huiyi-li/esp32_show_tv/cad/solidcraft/prismtv.png

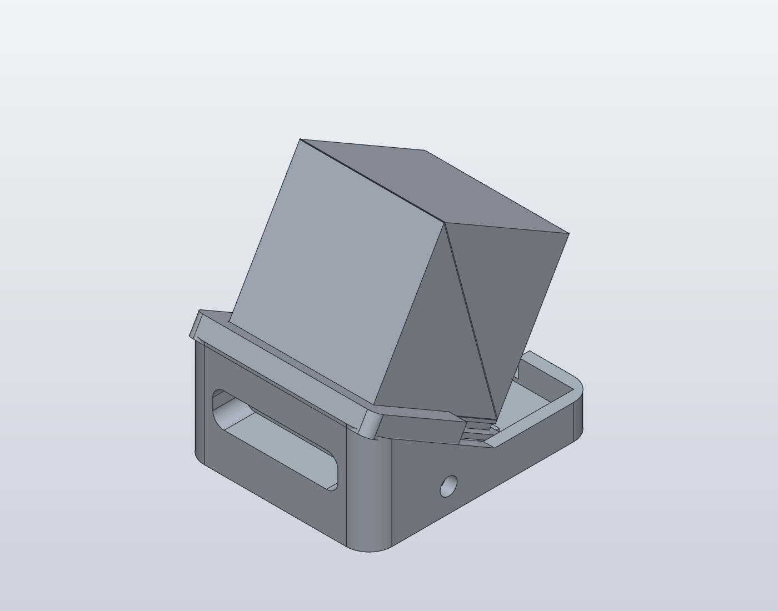
cad/solidcraft/prismtv.png
