huiyi-li/esp32_show_tv/DESIGN.md

# 25.4mm 分光棱镜「透明智能小电视」设计方案

> 参考项目：HoloCubic / 分光棱镜透明桌面小电视
> 核心器件：ESP32-PICO-D4 + MPU6050 + BH1750 + ST7789S(1.3" 240×240 IPS)
> 关键约束：25.4mm 分光棱镜立方体；两块 PCB（屏幕板 + 主板）

---

## 0. 参考项目原理（先对齐目标）

1:1 分光棱镜（Beam Splitter Cube）由两块直角棱镜胶合，胶合面镀 50/50 分光膜。

- 屏幕**水平放置、发光面朝上**，贴在中空的底座里。
- 25.4mm 立方体压在屏幕正上方，分光面与水平面成 **45°**。
- 屏幕向上的光，一半被 45° 分光面**反射到正面观察方向**，一半透射穿过后方。
- 观察者从前/侧方看，会看到**屏幕的镜像悬浮在立方体内部**，同时能透过立方体看到背景 → "透明"效果。

要复刻/超越它，光学几何是最硬约束，PCB 和结构都得围绕它让步。

---

## 1. 器件资料梳理

### 1.1 ESP32-PICO-D4（主控，SiP 系统级封装）

| 项目 | 参数 |
|---|---|
| 封装 | LGA-48，**7.0 × 7.0 × 0.94 mm** |
| 内核 | ESP32 双核 Xtensa LX6，最高 240 MHz |
| 片内 | **4 MB Quad-SPI Flash** + 40MHz 晶振 + RF 匹配 + 去耦，全部封装在内 |
| 无线 | 2.4GHz WiFi 802.11 b/g/n + BT 4.2 / BLE |
| 供电 | 2.7 – 3.6 V（标称 3.3 V） |
| 峰值电流 | WiFi TX 瞬时可达 ~500 mA（电源要留裕量） |

**必须注意的引脚：**

- `GPIO16 / GPIO17 / CMD / CLK / SD0 / SD1` 被内部 Flash 占用，**不可用**。
- **`GPIO6–11`** 同样接到内部 Flash（SPI0/1），**不可用**。
- 可用 GPIO：`0–5, 12–15, 18–23, 25–27, 32–39`。
- **Strapping 引脚（上电电平敏感）**：`0 / 2 / 5 / 12 / 15`
  - `GPIO12` 决定 Flash 电压，**上电时必须为低**，拉高会切到 1.8V 损伤内部 Flash → 干脆避开。
  - `GPIO5` 上电需为高（用作片选空闲态为高，OK）。
  - `GPIO15` 上电建议为高。
- `GPIO34/35/36/39` **仅输入**，无内部上拉。
- 无原生 USB → 必须外挂 USB-UART 桥。

> ⚠️ **选型提醒**：ESP32-PICO-D4 官方已标记 **NRND（不推荐新设计）**。量产/新项目建议换 **ESP32-PICO-V3-02**（8MB Flash + 2MB PSRAM，引脚基本兼容，PSRAM 对 LVGL 动画非常关键）。方案一/二可用 D4 打样验证，方案三直接上 V3-02。

### 1.2 MPU6050（六轴 IMU，姿态/手势）

| 项目 | 参数 |
|---|---|
| 封装 | QFN-24，**4 × 4 × 0.9 mm** |
| 测量 | 三轴加速度 ±2…±16g；三轴陀螺 ±250…±2000°/s |
| 接口 | I²C（0x68 / 0x69）或 SPI |
| 地址 | AD0 低 = **0x68**，AD0 高 = 0x69 |
| 供电 | 2.375 – 3.46 V |
| 额外 | 可编程中断 INT；内部温度计；DMP |
| 外围 | VDD 0.1µF + VLOGIC 10nF/0.1µF，CPOUT/REGOUT 按手册电容 |

> ⚠️ 市场**假片极多**（WHO_AM_I 读不到 0x68），且同样 NRND。建议备选 **QMI8658C**（3×3mm，0x6A/0x6B，国产好买）或 **ICM-42688-P**（低噪、SPI 快）。软件层做抽象，换片只改驱动。

### 1.3 BH1750FVI（数字环境光传感器）

| 项目 | 参数 |
|---|---|
| 封装 | WSOF6I 6 脚超小封装 |
| 量程 | **1 – 65535 lx**，16-bit 输出 |
| 接口 | I²C，最高 400kHz |
| 地址 | ADDR 低 = **0x23**，ADDR 高 = 0x5C |
| 供电 | 2.4 – 3.6 V |
| 引脚 | VCC / ADDR / GND / SDA / SCL / DVI（异步复位，按手册接电容或 VCC） |
| 外围 | VCC 1µF + 0.1µF |

**用途**：自动亮度（联动背光 PWM）；暗环境自动熄屏省电。
**地址不冲突**：BH1750 0x23 与 MPU6050 0x68 可共用一条 I²C 总线。

### 1.4 ST7789S（TFT 驱动，1.3" 240×240 IPS）

| 项目 | 参数 |
|---|---|
| 类型 | Sitronix 单芯片 TFT 驱动（ST7789 系列，注意核对"V/S"尾缀与面板规格） |
| 分辨率 | 240(RGB) × 320 源/栅，1.3" 面板实际用 **240×240** |
| 接口 | 4-line SPI（或 8080 并口） |
| 逻辑电压 IOVCC | **1.65 – 3.3 V**（3.3V 直连 ESP32 无需电平转换） |
| 模拟电压 VCC | 2.4 – 3.6 V |
| 颜色 | 262K / 65K |
| 升压 | VGH/VGL 内部电荷泵，**外接电容**（通常已做在面板 FPC 上） |
| 背光 | 白光 LED，Vf ≈ 2.8–3.2 V，约 15–20 mA |

**1.3" 240×240 模组常见 FPC（8-pin，0.5mm）**：`GND / VCC / SCL / SDA / RES / DC / CS / BLK`
→ 屏幕板只需：FPC 座 + 背光限流 + 少量去耦（驱动 IC 的电荷泵电容在面板上）。

### 1.5 25.4mm 分光棱镜（结构核心）

| 项目 | 参数 |
|---|---|
| 尺寸 | **25.4 × 25.4 × 25.4 mm**（±0.1mm），面对方正、棱边倒角 |
| 分光比 | 50 % R / 50 % T（宽带 400–700nm） |
| 胶合面 | 介质分光膜，装好后与水平面 45° |
| 可选 | 外表面 AR 镀膜（减少鬼影，强烈建议） |

**结论：屏幕有效区必须 ≤ 25.4mm。1.3" 240×240 的有效显示区约 23.4 × 23.4 mm，正好塞进 25.4mm 立方体并留约 1.0mm 遮光边 —— 这是选它的根本原因。**

### 1.6 I²C 总线上游/下游地址分配（不冲突）

| 器件 | 7-bit 地址 | 总线 |
|---|---|---|
| MPU6050 | 0x68 | 主板 I²C |
| BH1750 | 0x23 | 主板 I²C（或经板对板走 SDA/SCL） |

---

## 2. 光学与结构约束（一切设计的前提）

1. **屏幕居中**：显示区中心必须与棱镜底面中心重合并平行，偏差 < 0.5mm，否则出现色偏/重影。
2. **贴合间隙**：面板发光面尽量靠近棱镜底面（间隙 0.3–1mm），间隙越大鬼影越明显。
3. **遮光**：屏幕与棱镜之间加**黑色遮光框/遮光棉**，只在显示区留窗；否则漏光会在棱镜里形成"底光"。
4. **装棱镜方向**：分光面法线需在水平面内，使"底面朝上的光 → 反射到正面观察方向"。装反了就是从背面看。
5. **固定方式**：结构卡座 + 硅胶垫限位，**禁止用会发雾/析出的胶**粘镜面；可在棱镜**棱边**点 UV 胶固定。
6. **视角**：±30° 内成像稳定；大角度会看到立方体棱边的二次反射，属正常。
7. **背光散热**：背光 LED 发热，屏幕板在 LED 区铺铜并接到主板地。
8. **可选进阶**：棱镜底面与面板之间做**光学胶/折射率匹配**或给棱镜外表面加 AR 膜，可显著降低双影。

---

## 3. 为什么拆两块 PCB（屏幕板 + 主板）

棱镜正下方只有 25.4mm 窗口，越薄越干净；而 MCU/电源/USB/传感器堆叠密度大、需要更大面积。因此天然分成两块：

| | 屏幕板（Display Board） | 主板（Main Board） |
|---|---|---|
| 位置 | 棱镜正下方，紧贴面板 | 屏幕板下方，底座内 |
| 尺寸建议 | **≤ 28 × 28 mm** | 30 × 35 mm 左右，可调味 |
| 层数 | 2 层 | 4 层（WiFi 强烈建议） |
| 内容 | 面板 FPC 座、背光驱动（限流/恒流+PWM MOSFET）、ESD、去耦、（可选）BH1750 朝外 | ESP32-PICO-D4、USB-C+ESD、USB-UART 桥、3.3V 电源、自动下载电路、按键、MPU6050、触摸焊盘、测试点 |
| 传感器放哪 | **BH1750 放屏幕板顶端朝外**（采真实环境光，不被棱镜/外壳挡） | **MPU6050 放主板**（减薄屏幕板，且整机倾角一致） |

### 3.1 两板互联接口定义（推荐 12-pin）

| Pin | 信号 | 说明 |
|---|---|---|
| 1 | 3V3 | 显示屏 IOVCC/VCC |
| 2 | GND | 地 |
| 3 | GND | 地（双地降低 SPI 回流噪声） |
| 4 | TFT_SCLK | SPI 时钟 |
| 5 | TFT_MOSI | SPI 数据 |
| 6 | TFT_CS | 片选 |
| 7 | TFT_DC | 数据/命令 |
| 8 | TFT_RST | 复位（可共享 EN） |
| 9 | TFT_BL | 背光 PWM |
| 10 | I2C_SDA | 给屏幕板 BH1750（若 BH1750 放主板则删掉） |
| 11 | I2C_SCL | 同上 |
| 12 | GND | 屏蔽/机械地 |

**连接器选型**：0.4/0.5mm pitch 板对板（Hirose DF40、Molex SlimStack，高度 1.5–3.0mm），或 0.5mm 12P FPC 带补强板 Z 型折弯。两板间隙建议 2–4mm，且主板元件尽量放**背面朝下**，避免顶到屏幕板。

---

## 4. 通用 PCB 设计要点（三方案共用）

### 4.1 叠层与阻抗
- **主板 4 层**：`Top(Sig) / GND(完整) / PWR / Bottom(Sig)`。ESP32 要有一个**不打洞的完整参考地**。
- **屏幕板 2 层**：正面信号，背面整片 GND，SPI 走线两侧包地。
- 若用外置天线：馈线 **50Ω 共面波导**，长度尽量短。

### 4.2 天线
- 板载 PCB 天线（倒 F / 蛇形）净空区约 **15 × 8 mm**：该区**不许铺铜、不许走线、不许上螺钉/金属**。
- 净空区放在**主板远离棱镜、远离电池**的边缘；整机装配后棱镜/屏幕在另一侧，不挡天线。
- 空间紧张直接用 **U.FL + 外置 FPC 天线**，贴在外壳非金属区。

### 4.3 电源
- 5V→3.3V：优先 **同步 Buck**（如 TPS62162/MP2315），效率高、压差小；空间允许可用低噪 LDO（RT9013/AP2112）做"干净 3.3V"给屏和传感器。
- ESP32 电源脚：每脚 **0.1µF + 就近 10~22µF 大容量**，应对 WiFi TX 电流尖峰。
- 背光：**PWM MOSFET（2N7002）+ 限流电阻**，PWM 频率 **> 10kHz** 避免可见频闪；白光 LED 可加恒流驱动（如 SGM3140）保证亮度一致。
- USB-C 入口：**USBLC6-2SC6** 之类 ESD；CC1/CC2 各 5.1k 下拉（做 Sink）。

### 4.4 去耦清单
- ESP32-PICO-D4：模块自带滤波，外围补 10µF + 0.1µF。
- MPU6050：0.1µF + 手册推荐的 0.1µF/10nF（VLOGIC）+ CPOUT/REGOUT 电容。
- BH1750：1µF + 0.1µF。
- ST7789 电荷泵电容一般在**面板 FPC 上**，屏幕板只需 VCC 侧 1µF + 0.1µF。

### 4.5 信号完整性
- SPI 跨板对板连接器，走线尽量 < 5cm；如振铃，在 SCLK/MOSI 串 **22–33Ω** 源端电阻；速率先 40MHz，稳了再提。
- I²C：**4.7k 上拉**到 3.3V，走线短，与 SPI 保持间距避免串扰。
- USB D+/D-：**90Ω 差分对**，等长，包地。
- 所有跨板信号地回流要有相邻 GND pin。

### 4.6 可制造性/可调试性
- 预留测试点：`3V3 / GND / TX / RX / EN / IO0 / SDA / SCL / SCLK / MOSI`。
- 屏幕板与主板都放 **Mark 点**（贴片机用）和 **安装孔**。
- 丝印标注 Pin1、连接器方向、棱镜"前/上"方向，避免装反。

---

## 5. 三个完整设计方案

---

### 方案一 ｜ 快速原型版（先点亮、验证光学）

**定位**：两周内出效果，验证驱动 + 光学 + 软件链路，牺牲体积与集成度。

**结构**
- 屏幕板 30×30mm，主板沿用现成 ESP32 开发板外形（约 40×60mm）。
- 两板用 **2.54mm 排针 + 杜邦线/FFC** 连接。
- 棱镜用 3D 打印 PLA 卡座架在屏幕上，缝隙塞黑色遮光泡棉。
- 无电池，USB 直供电；外壳省略或简单亚克力。

**硬件**
- 主板直接用**现成 ESP32-PICO-D4 核心板**（其自带 USB-UART + LDO），只画一块底板引出排针即可，甚至不画。
- 屏幕板：1.3" 240×240 FPC 座 + 背光电阻/MOSFET + 2×7 排针。
- 传感器用现成 GY-521(MPU6050)、GY-302(BH1750) 小板飞线接 I²C。

**软件**
- Arduino IDE + **TFT_eSPI**（`User_Setup.h` 配 240×240 ST7789，改 `ST7789_DRIVER`、`TFT_WIDTH 240 / TFT_HEIGHT 240`）。
- 单 `loop()`：NTP 对时（`NTPClient`，注意 +8h 时区）+ 心知天气 HTTP/`HTTPClient` 解析 JSON + `pushImage()` 播放取模图片数组。
- WiFi 直连（SSID/密码硬编码）。

**优点**：最快见效、成本最低。<br>
**缺点**：体积大、连线多、无电源管理、动画受 4MB Flash 限制。

---

### 方案二 ｜ 高集成双板版（★ 推荐主力方案）

**定位**：自用/小批量，体积收敛、功能完整、可量产。

**结构**
- 整机约 **36 × 36 × 45 mm**：3D 打印/CNC 外壳，内部黑色内衬遮光。
- **屏幕板 28×28mm** 紧贴棱镜底面，遮光框留显示窗。
- **主板 30×32mm**，垂直置于屏幕板下方约 3mm，用 **0.5mm 12P 板对板连接器**连接。
- 棱镜卡座限位 + 顶部磁吸前盖，方便取放棱镜。
- 侧面开 BH1750 透光窗（不被棱镜/手挡）、USB-C 开口；外壳内侧贴铜箔做电容触摸条。

**硬件**
- **主板（4 层）**：ESP32-PICO-D4 + USB-C(TVS) + CH340C/CV3000P + 自动下载电路(2× SOT-23 三极管 DTR/RTS→EN/IO0) + BOOT/EN 按键 + 3.3V Buck/LDO + MPU6050 + BH1750 + 触摸焊盘 + 可选 WS2812 + 测试点。
- **屏幕板（2 层）**：0.5mm FPC 座 + 背光限流 + PWM MOSFET + ESD + 去耦 + 板对板连接器。
- 天线：主板边缘 PCB 天线，净空区远离棱镜与屏幕。

**软件（ESP-IDF 或 Arduino-as-component）**
- **LVGL 8/9** 做 UI，SPI 40MHz；双缓冲需约 2×(240×240×2/10) ≈ 23KB，D4 的 4MB Flash 够用，帧缓存放内部 RAM 分块刷。
- **FreeRTOS 多任务**：

  | 任务 | 核心 | 职责 |
  |---|---|---|
  | `ui_task` | Core1 | LVGL 刷新、动画、页面切换 |
  | `sensor_task` | Core0 | 10–50Hz 读 MPU6050 + BH1750，做自动亮度/翻转/摇动 |
  | `net_task` | Core0 | WiFi、NTP、天气 HTTP、图片 WebSocket 接收 |
  | `pwr_task` | Core0 | 空闲降频/熄屏、背光 PWM 联动 |

- **配网**：AP 模式 + 内置网页（WiFiManager 或自建），mDNS `holocubic.local`。
- **图片/动图**：PC/手机网页把 GIF/JPEG 通过 **WebSocket/HTTP 上传**到 ESP32 解码显示（比取模数组灵活）。
- **OTA**：`ArduinoOTA` 或 `esp_https_ota`。
- **交互**：MPU6050 翻转→切界面、摇一摇→换页；BH1750→自动亮度/熄屏；触摸条→上下页。

**优点**：体积小、体验完整、可复制。<br>
**缺点**：需画两块板 + 调结构。

---

### 方案三 ｜ 旗舰全功能版（可量产产品化）

**定位**：接近商品级，音视频、电池、一体化光学。

**结构**
- 一体化注塑/CNC 外壳 + **光学级装配**：棱镜底面与面板做折射率匹配/AR 膜，最大化消除双影。
- 前盖磁吸/卡扣，**兼容 15/20/25.4mm 棱镜**（换件即换尺寸）。
- 屏幕板集成**电容触摸条 + 朝外 BH1750 + 氛围灯**；主板堆电池、功放、SD 卡。
- 底部配重 + 硅胶防滑，重心低防倒。

**硬件**
- **主板（4–6 层）**：**ESP32-PICO-V3-02（8MB Flash + 2MB PSRAM，LVGL 双缓冲/视频帧）** + USB-C + 锂电充电（BQ24075/TP4056）+ 电量计（MAX17048）+ I²S 功放（NS4168）+ microSD + MPU6050(或 ICM-42688/QMI8658) + BH1750 + 触摸。
- **屏幕板**：高密板对板/屏蔽 FPC，含背光恒流、缓冲/串阻、温度检测。
- 双板用**屏蔽连接器**，SPI 提频到 60–80MHz。

**软件**
- **LVGL 9 + 多界面**：时钟/天气/相册/视频/设置。
- 视频/GIF **流式播放**（PSRAM 帧缓存 + 局部刷屏），WiFi 或 SD 卡读取。
- **BLE 配网 + Web/App 上传**、mDNS、OTA。
- **电源管理**：MPU6050 中断/触摸唤醒深睡眠；电量显示；低电保护。
- 传感器融合：姿态稳定显示方向，手势/轻敲交互。

**优点**：体验与形态最好、可产品化。<br>
**缺点**：BOM 成本、结构/光学调优、开发周期最长。

---

## 6. 三方案对比

| 维度 | 方案一 原型 | 方案二 高集成（推荐） | 方案三 旗舰 |
|---|---|---|---|
| 体积 | 大（>60×60×80） | ~36×36×45mm | ~34×34×42mm |
| PCB | 1–2 块，排针 | 双板，板对板 | 双板，屏蔽高密 |
| 层数 | 2 | 主板 4 / 屏板 2 | 主板 4–6 / 屏板 2 |
| 主控 | PICO-D4 核心板 | PICO-D4 | **PICO-V3-02(PSRAM)** |
| 显示 | TFT_eSPI | LVGL | LVGL9 + 视频 |
| 电源 | USB 直供 | USB-C + 3.3V | 锂电+充电+电量计 |
| 交互 | 无/串口 | 翻转/摇动/触摸/自动亮度 | 全手势+音频 |
| 联网 | 硬编码 WiFi | AP 配网 + OTA + 推图 | BLE 配网 + App + OTA |
| 周期 | ~2 周 | ~6–8 周 | ~3–4 月 |
| 适合 | 验证/教学 | 自用/小批量 | 产品化 |

---

## 7. 默认引脚分配（方案二/三可直接用）

| 功能 | ESP32-PICO 引脚 | 备注 |
|---|---|---|
| TFT_SCLK | GPIO18 | VSPI CLK |
| TFT_MOSI | GPIO23 | VSPI MOSI |
| TFT_CS | GPIO5 | 空闲为高，满足 strapping |
| TFT_DC | GPIO27 | |
| TFT_RST | GPIO33 | 或接 EN |
| TFT_BL | GPIO32 | LEDC PWM，>10kHz |
| I²C SDA | GPIO21 | 4.7k 上拉 |
| I²C SCL | GPIO22 | 4.7k 上拉 |
| MPU6050 INT | GPIO34 | 仅输入，OK |
| 触摸条 | GPIO4 | ESP32 Touch T0 |
| 状态灯/WS2812 | GPIO25 | |
| VBUS 检测 | GPIO35 | 仅输入 |
| BOOT | GPIO0 | 按键/strapping |
| EN | EN | 按键 + RC 复位 |

**禁用**：`GPIO6–11、16、17`（内部 Flash）；`GPIO12`（Flash 电压，勿拉高）。

---

## 8. 风险与选型建议清单

1. **ESP32-PICO-D4 = NRND** → 新项目优先 **PICO-V3-02**（+PSRAM，动画/视频必需）。
2. **MPU6050 假片多且 NRND** → 优先 **QMI8658C / ICM-42688-P**，驱动做抽象。
3. **棱镜鬼影/双影** → 面板贴近棱镜 + 遮光框 + 棱镜 AR 膜/折射率匹配。
4. **背光频闪** → PWM >10kHz；多颗 LED 用恒流驱动保亮度一致。
5. **WiFi 电流尖峰导致复位** → 模块旁 22µF + 0.1µF，走线短粗。
6. **天线被挡** → 净空 15×8mm，远离棱镜/电池/整片地；必要时外置 FPC 天线。
7. **4MB Flash 装不下动画** → 用 WiFi 推流/SD 卡，或直接上 PSRAM 版。
8. **SPI 跨板振铃** → 源端串 22–33Ω，先 40MHz 再提。
9. **棱镜固定发雾** → 只在棱边点 UV 胶 + 硅胶垫，禁止胶接触镜面。
10. **电池安全** → 走正规充电 IC，加过放/过流保护。

---

## 9. 下一步建议

1. 先按**方案一**用现成模块点亮 ST7789 + NTP/天气，确认光学效果。
2. 同步定 **1.3" 240×240 ST7789S 面板 FPC 定义**（脚位/背光电压）和**棱镜规格**（25.4mm/50:50/是否 AR）。
3. 冻结**方案二**的 12P 板对板接口与两板尺寸，出 3D 结构验证棱镜装配。
4. 最后决定是否上 PSRAM 版做**方案三**。
