huiyi-li/esp32_show_tv/cad/out/render/01_整机_等距.png

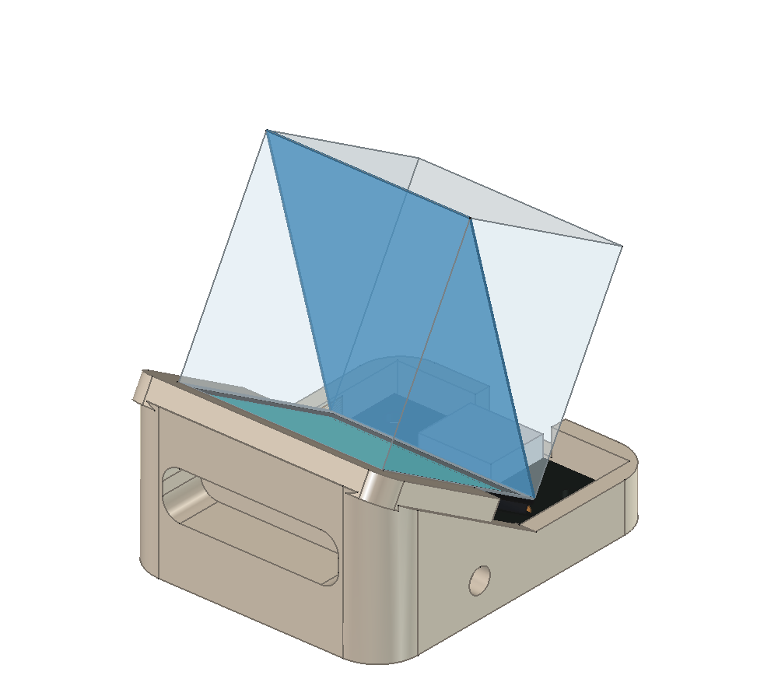
cad/out/render/01_整机_等距.png
