huiyi-li/esp32_show_tv/cad/out/render/02_整机_用户视角.png

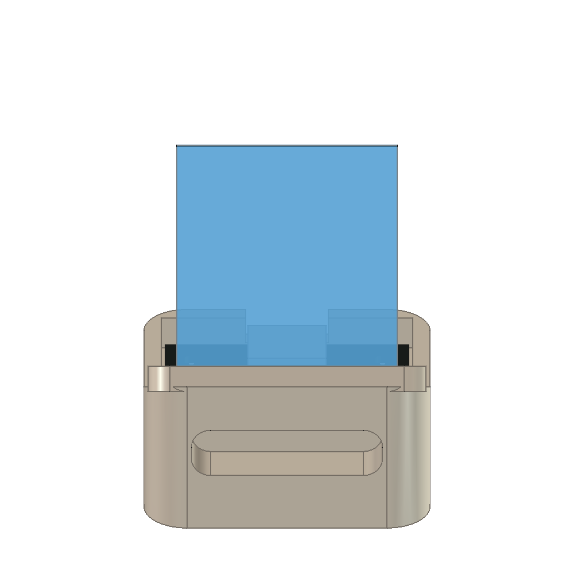
cad/out/render/02_整机_用户视角.png
