huiyi-li/esp32_show_tv/cad/out/render/03_整机_侧视.png

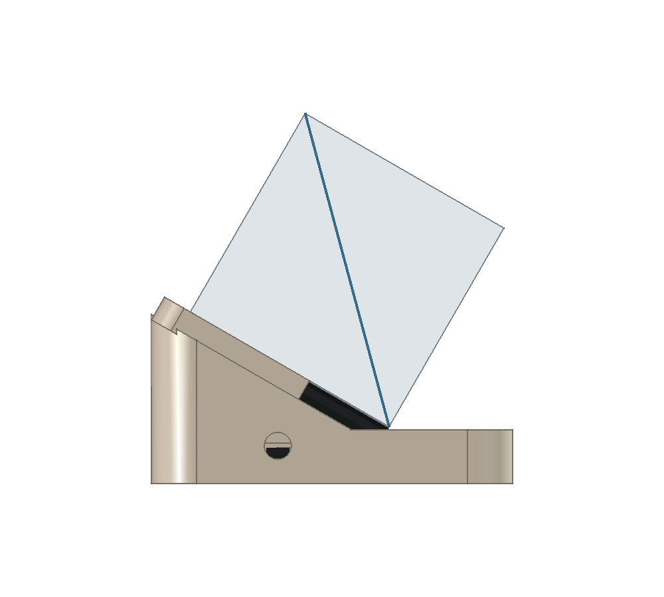
cad/out/render/03_整机_侧视.png
