huiyi-li/esp32_show_tv/cad/out/render/05_去掉棱镜_看显示.png

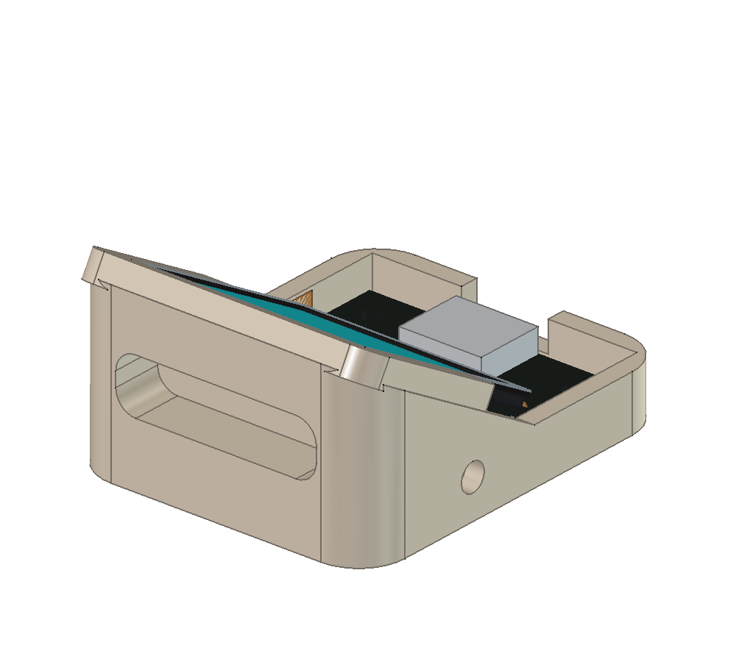
cad/out/render/05_去掉棱镜_看显示.png
