huiyi-li/esp32_show_tv/cad/out/render/06_主板元件面.png

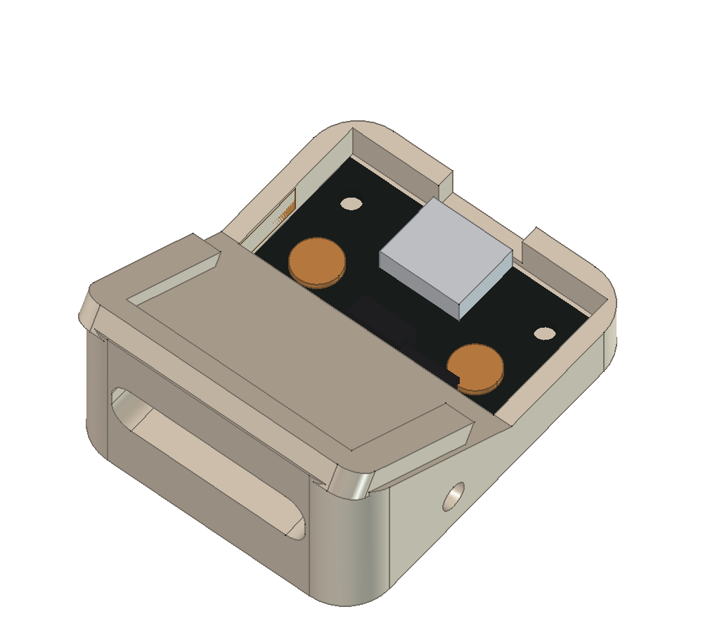
cad/out/render/06_主板元件面.png
