huiyi-li/esp32_show_tv/cad/out/render/07_爆炸图.png

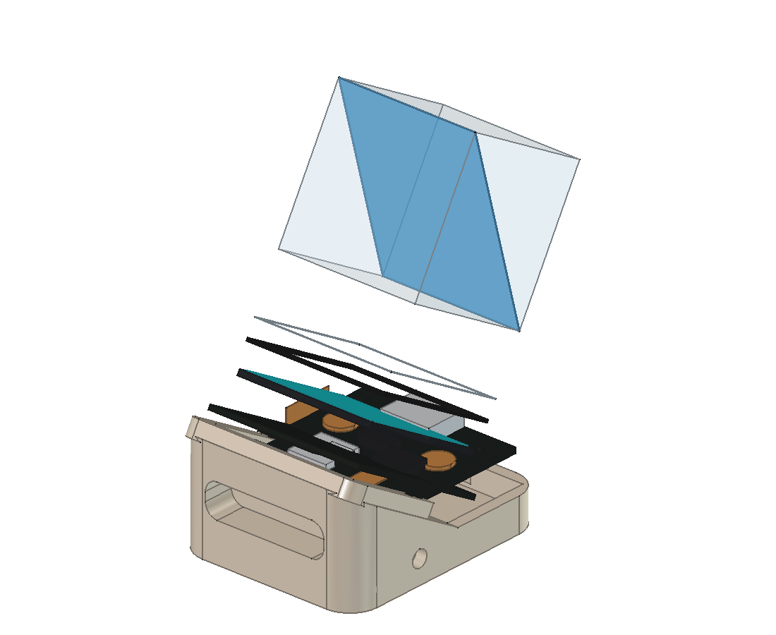
cad/out/render/07_爆炸图.png
