huiyi-li/esp32_show_tv/cad/out/render/08_剖视_光路.png

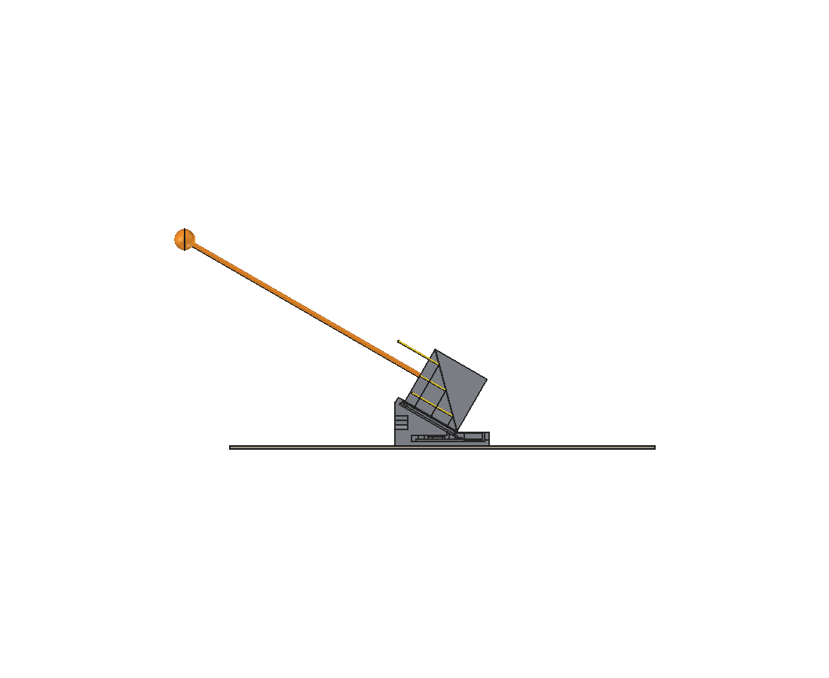
cad/out/render/08_剖视_光路.png
