huiyi-li/esp32_show_tv/cad/out/图纸/P01_外壳底座_零件图.png

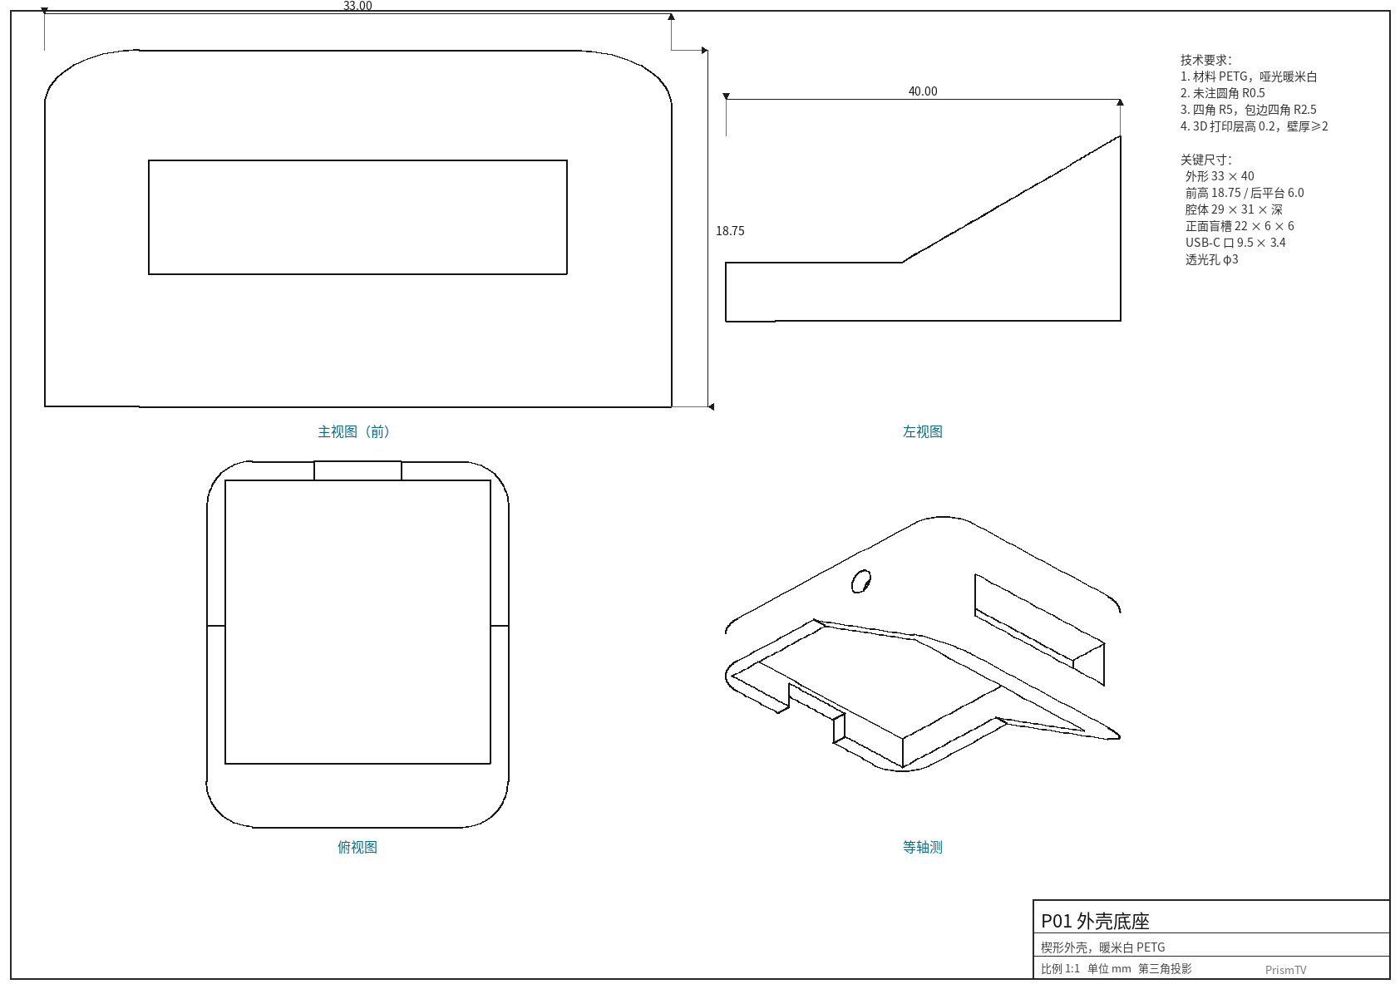
cad/out/图纸/P01_外壳底座_零件图.png
