huiyi-li/esp32_show_tv/cad/out/图纸/P02_棱镜托台_零件图.png

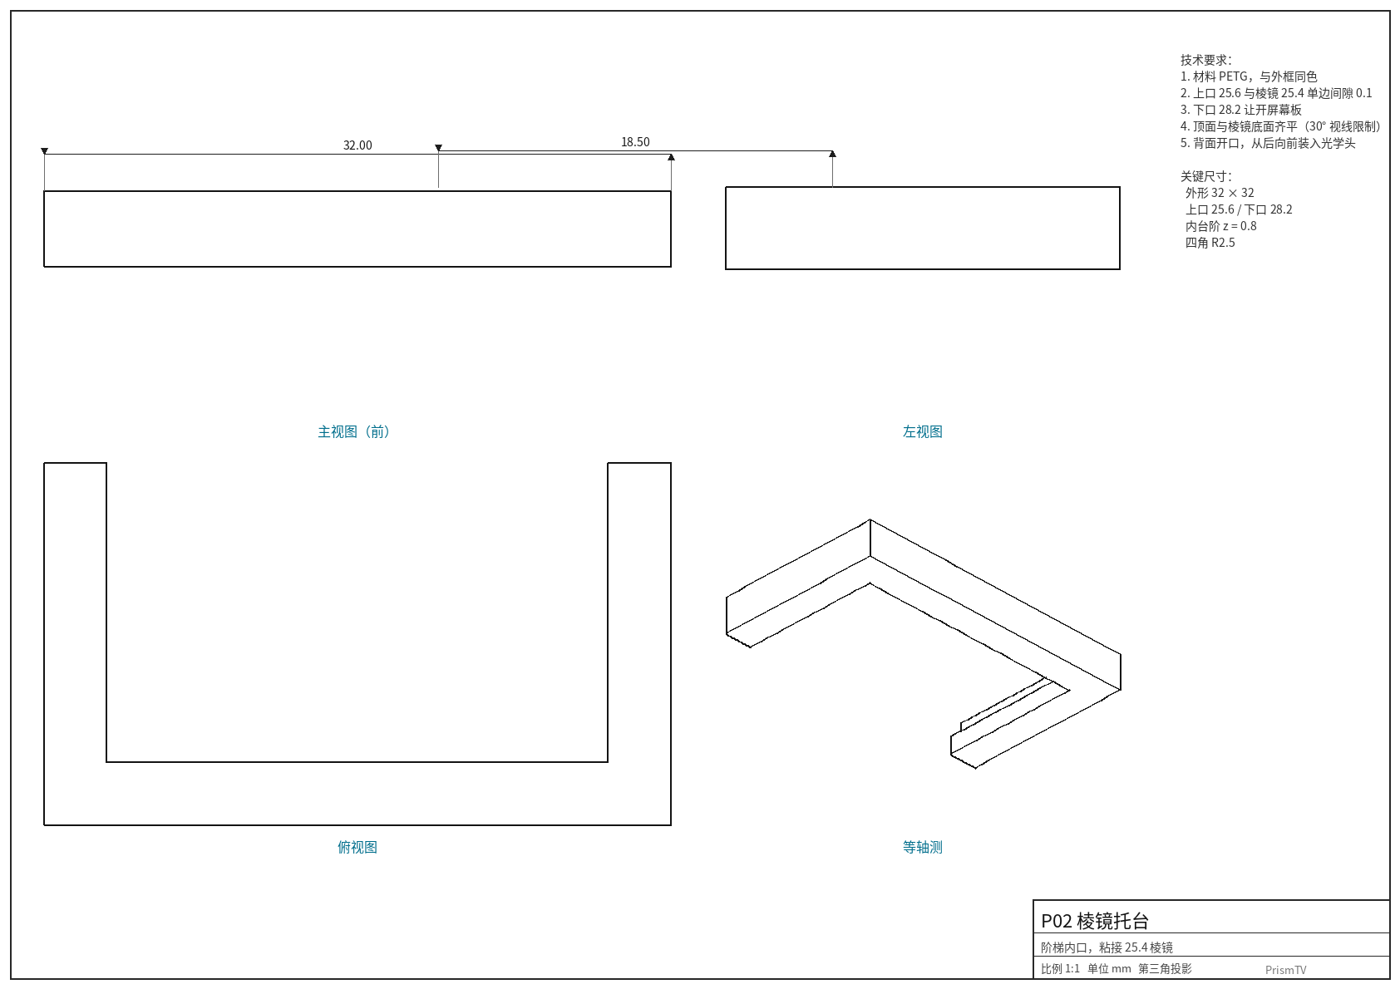
cad/out/图纸/P02_棱镜托台_零件图.png
