huiyi-li/esp32_show_tv/cad/out/渲染总览.png

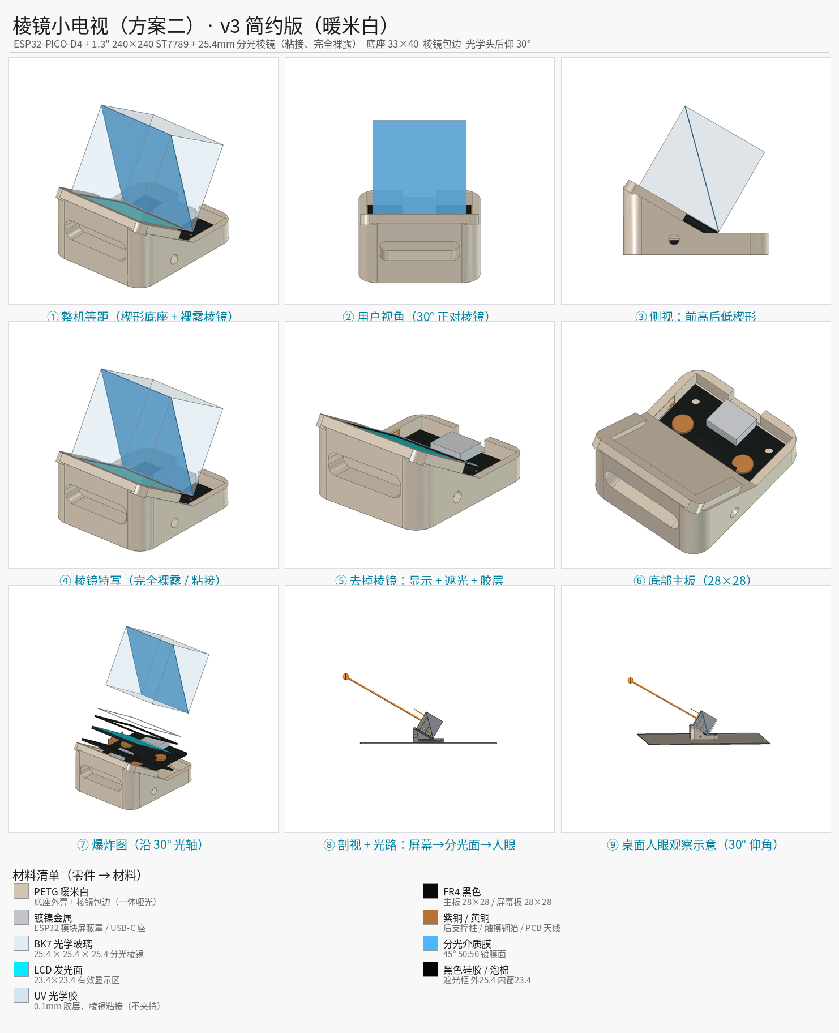
cad/out/渲染总览.png
