huiyi-li/esp32_show_tv/cad/out_v1_vertical/render/02_正视_观察方向.png

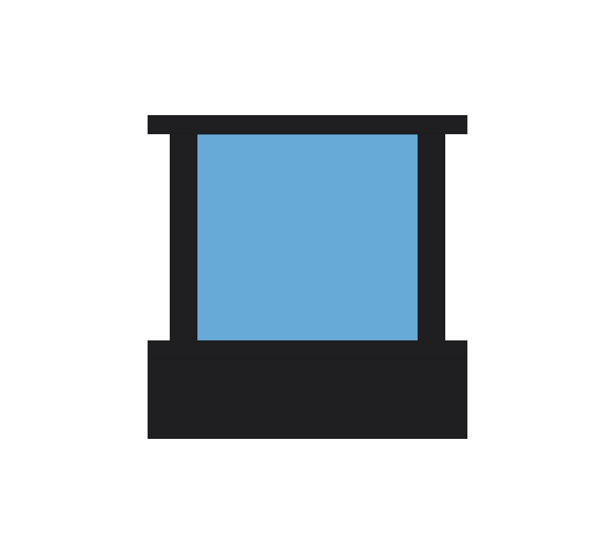
cad/out_v1_vertical/render/02_正视_观察方向.png
