huiyi-li/esp32_show_tv/cad/out_v1_vertical/render/03_侧视.png

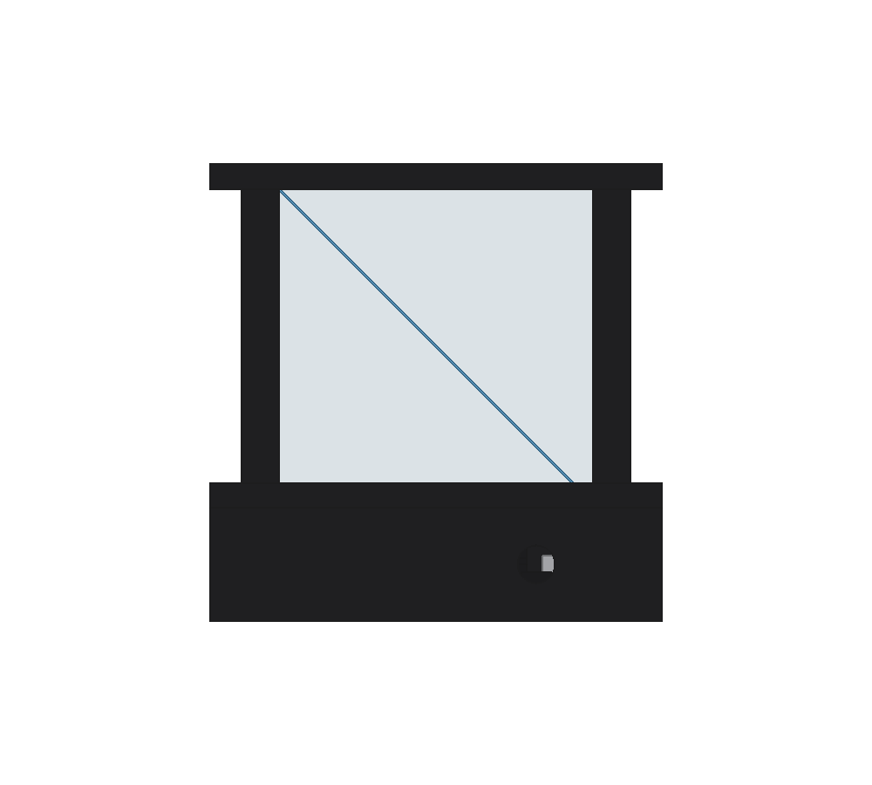
cad/out_v1_vertical/render/03_侧视.png
