huiyi-li/esp32_show_tv/cad/out_v1_vertical/render/05_内部双板结构.png

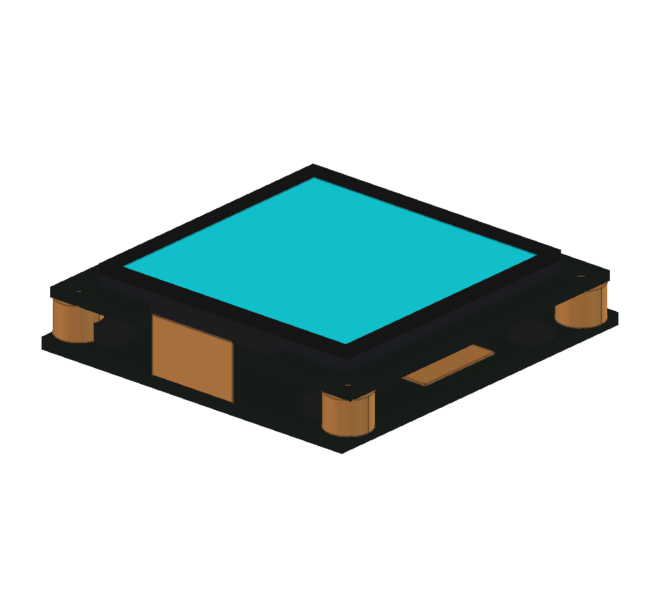
cad/out_v1_vertical/render/05_内部双板结构.png
