huiyi-li/esp32_show_tv/cad/out_v1_vertical/render/05b_主板元件面.png

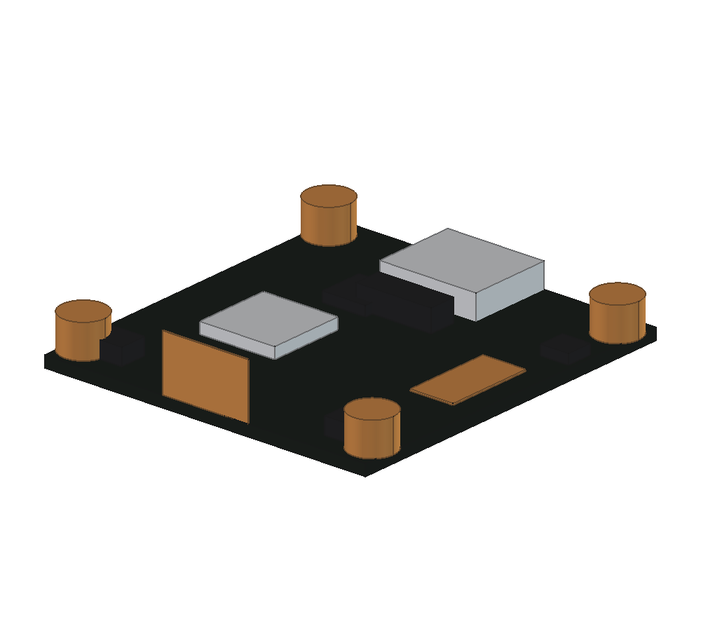
cad/out_v1_vertical/render/05b_主板元件面.png
