huiyi-li/esp32_show_tv/cad/out_v1_vertical/render/06_显示与遮光层.png

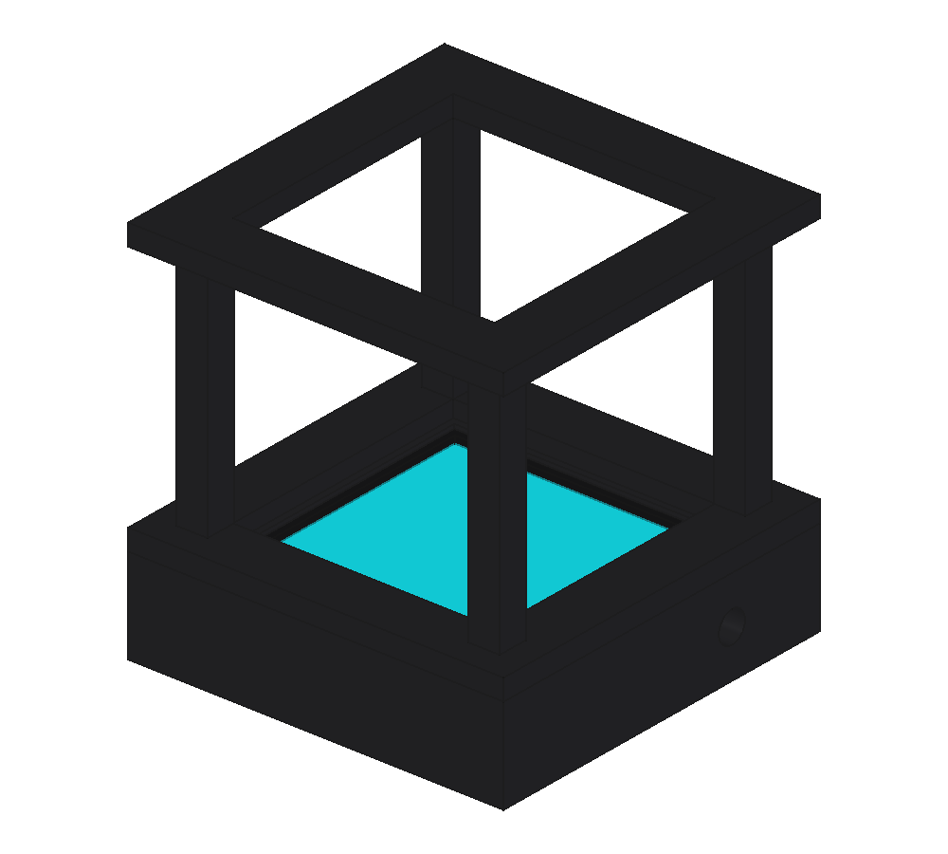
cad/out_v1_vertical/render/06_显示与遮光层.png
