huiyi-li/esp32_show_tv/cad/out_v1_vertical/render/07_爆炸图.png

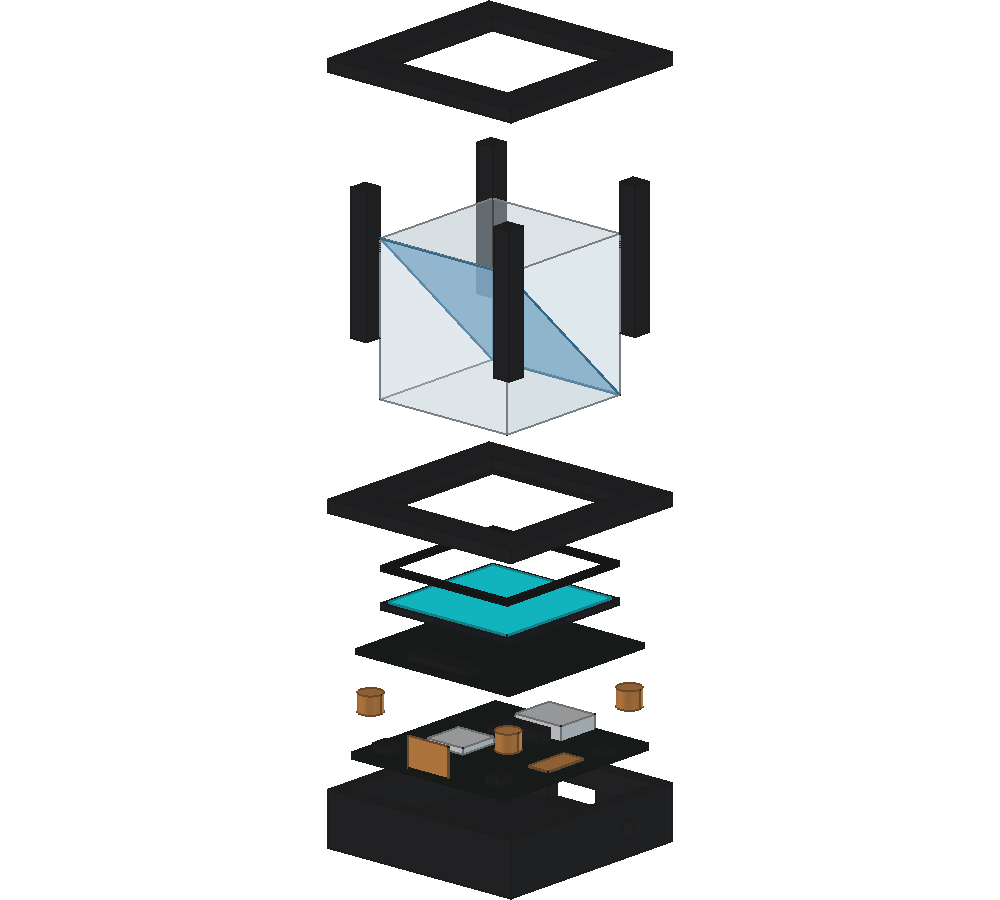
cad/out_v1_vertical/render/07_爆炸图.png
