huiyi-li/esp32_show_tv/cad/out_v1_vertical/render/08_剖视_光路.png

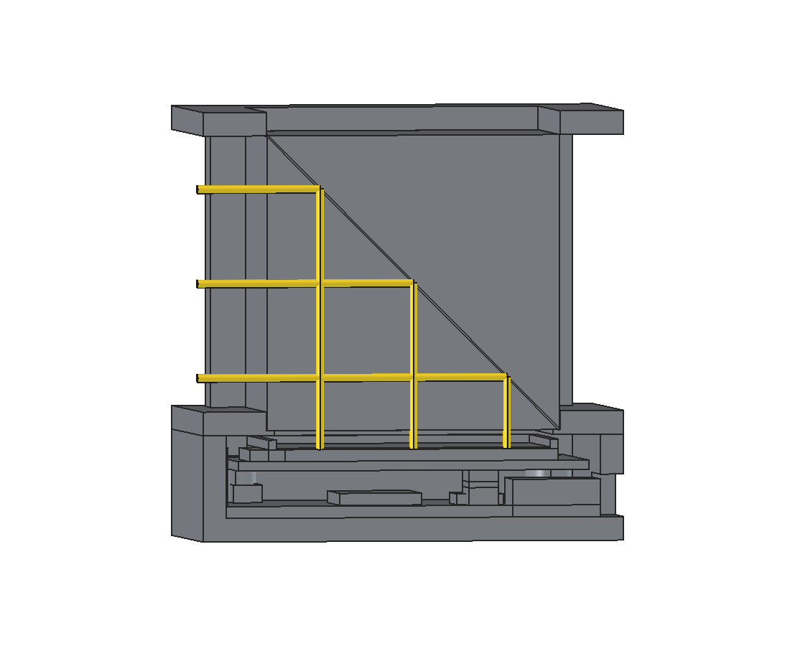
cad/out_v1_vertical/render/08_剖视_光路.png
