huiyi-li/esp32_show_tv/cad/out_v1_vertical/render/09_光路_总览.png

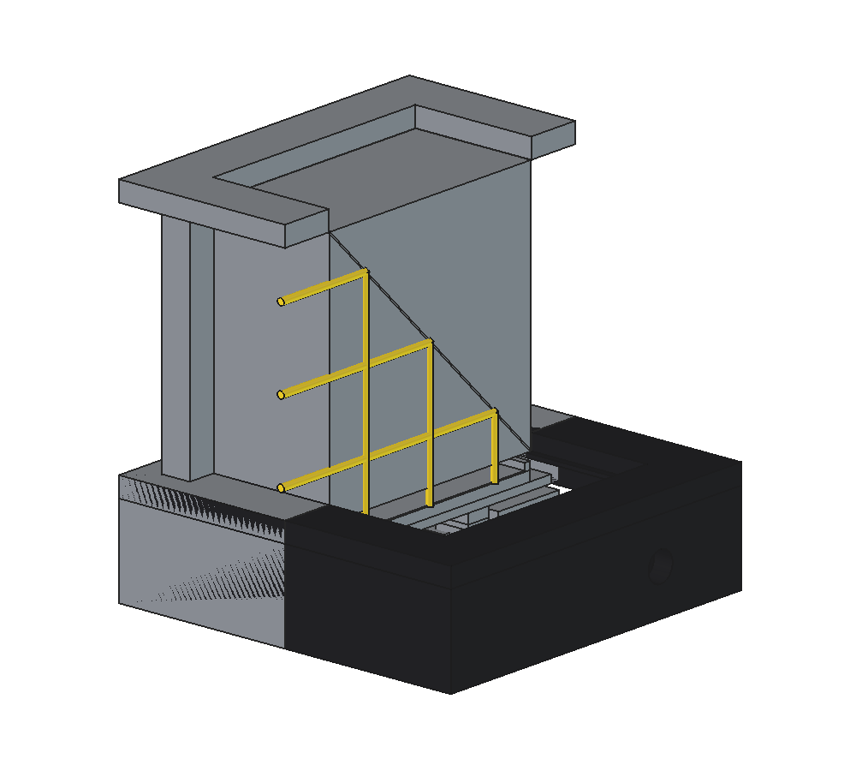
cad/out_v1_vertical/render/09_光路_总览.png
