huiyi-li/esp32_show_tv/cad/out_v1_vertical/渲染总览.png

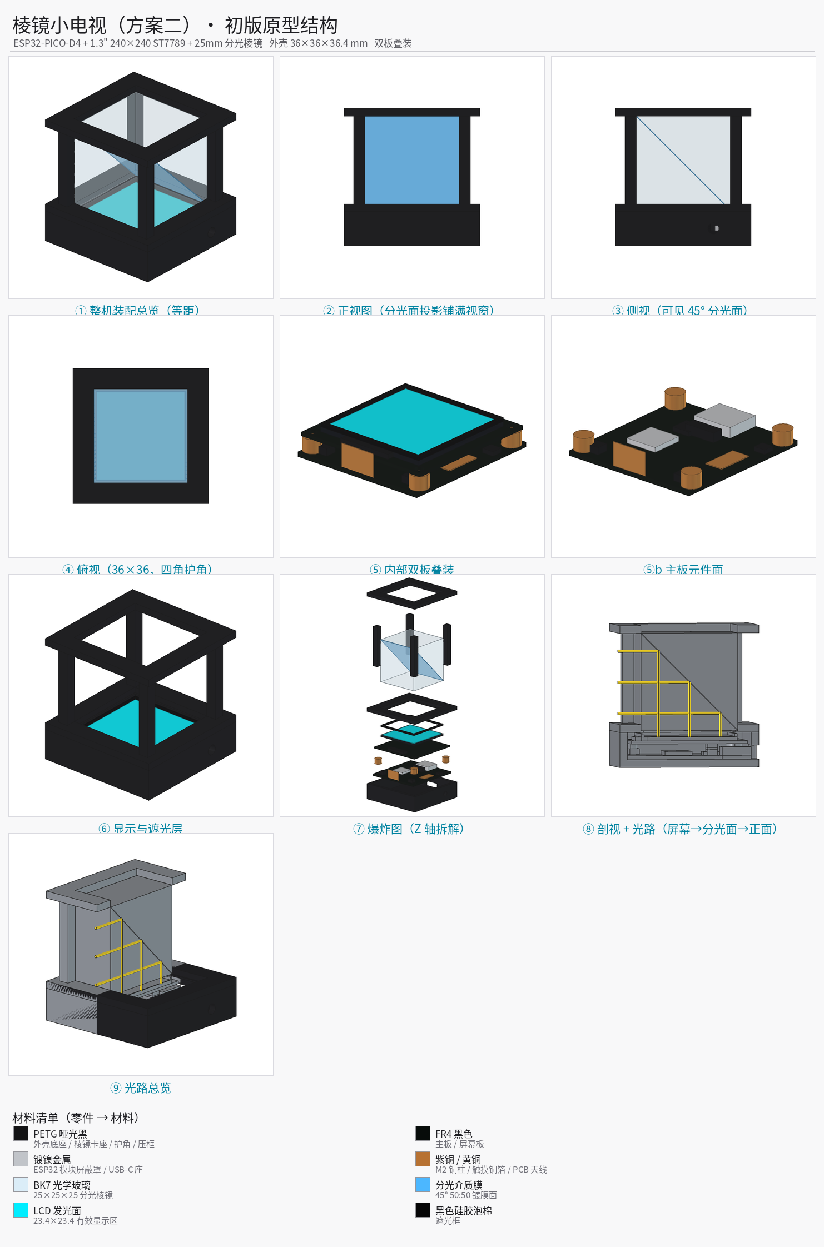
cad/out_v1_vertical/渲染总览.png
