huiyi-li/esp32_show_tv/cad/out_v2_tilt30/render/02_用户视角_正对棱镜.png

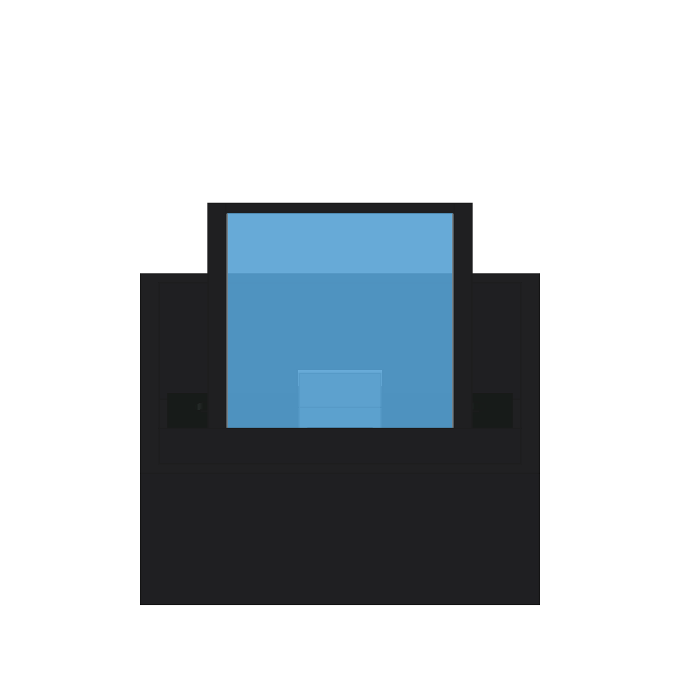
cad/out_v2_tilt30/render/02_用户视角_正对棱镜.png
