huiyi-li/esp32_show_tv/cad/out_v2_tilt30/render/03_侧视_30度仰角.png

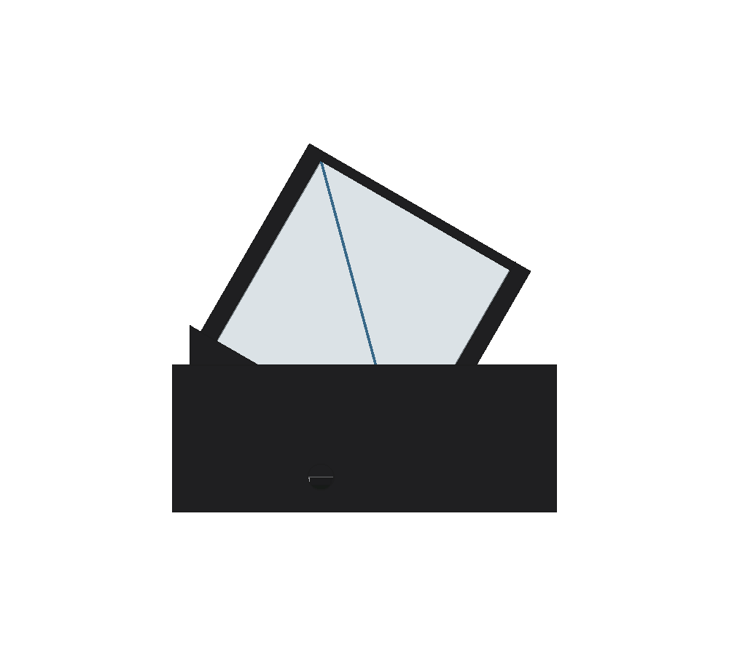
cad/out_v2_tilt30/render/03_侧视_30度仰角.png
