huiyi-li/esp32_show_tv/cad/out_v2_tilt30/render/04_俯视.png

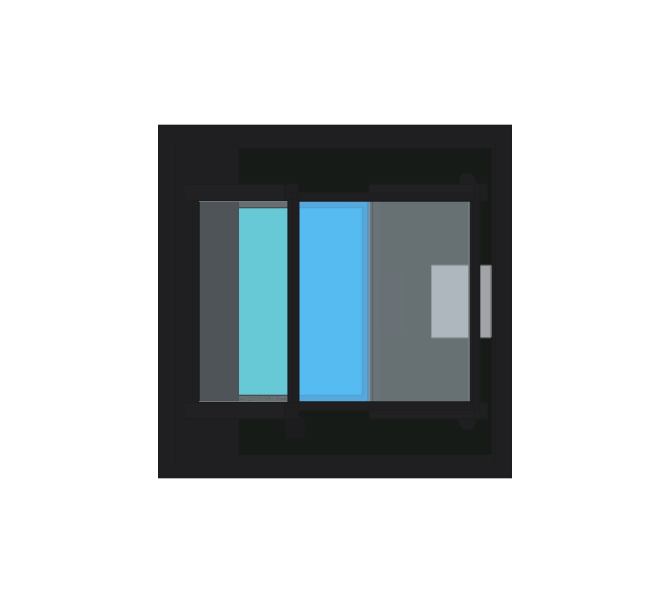
cad/out_v2_tilt30/render/04_俯视.png
