huiyi-li/esp32_show_tv/cad/out_v2_tilt30/render/05_光学头_内部.png

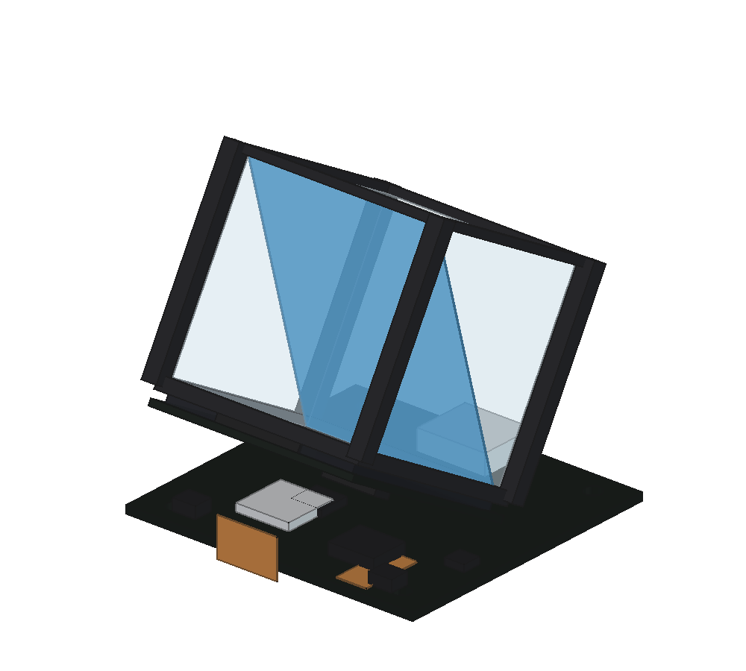
cad/out_v2_tilt30/render/05_光学头_内部.png
