huiyi-li/esp32_show_tv/cad/out_v2_tilt30/render/06_显示与遮光层.png

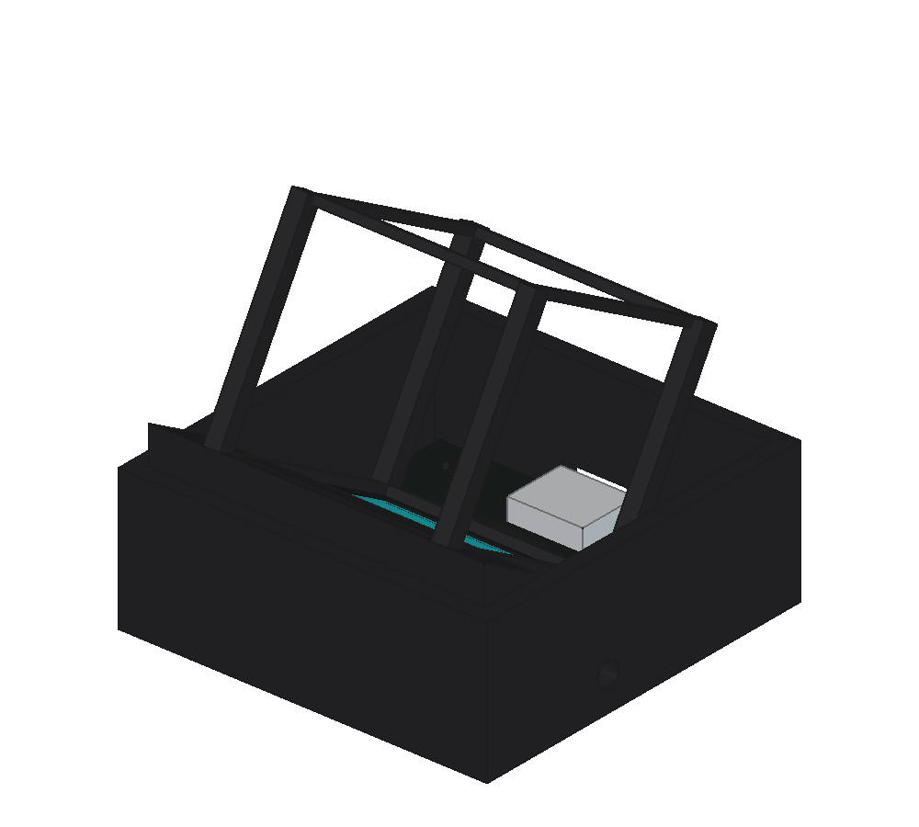
cad/out_v2_tilt30/render/06_显示与遮光层.png
