huiyi-li/esp32_show_tv/cad/out_v2_tilt30/render/07_主板元件面.png

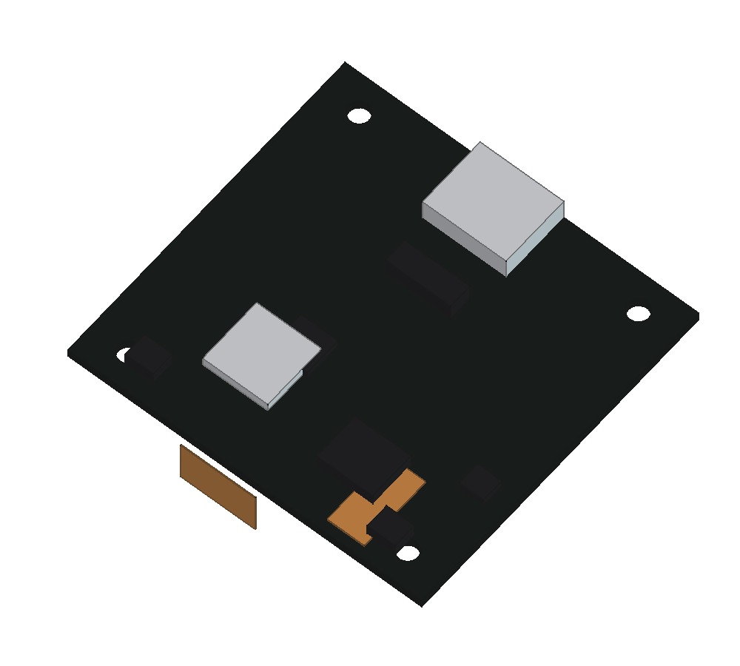
cad/out_v2_tilt30/render/07_主板元件面.png
