huiyi-li/esp32_show_tv/cad/out_v2_tilt30/render/08_爆炸图.png

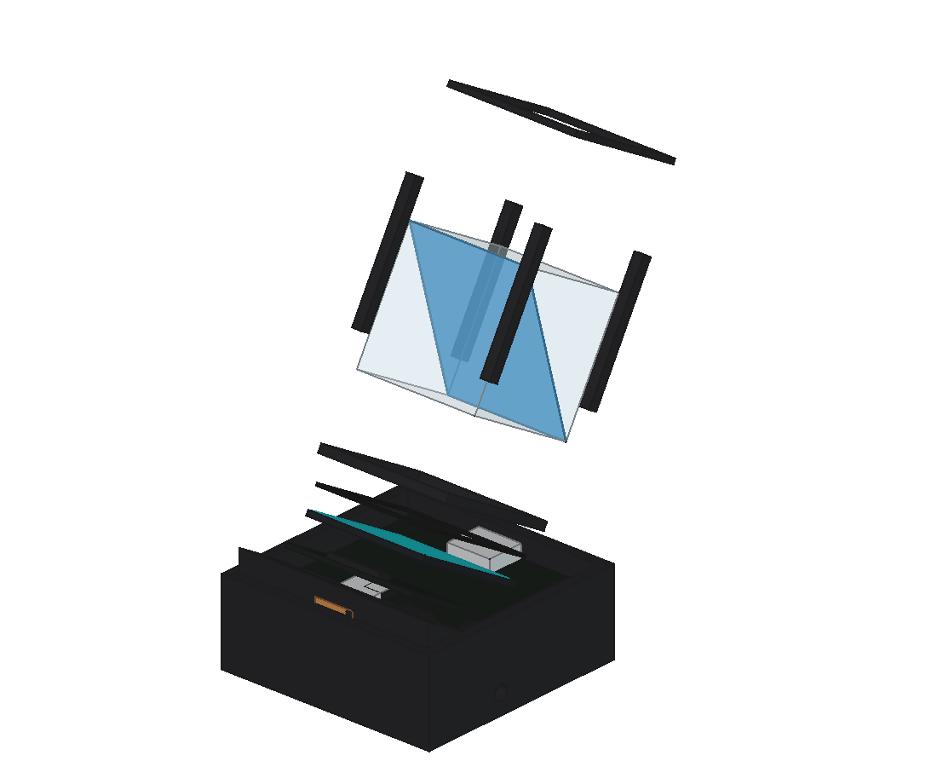
cad/out_v2_tilt30/render/08_爆炸图.png
