huiyi-li/esp32_show_tv/cad/out_v2_tilt30/render/09_剖视_光路.png

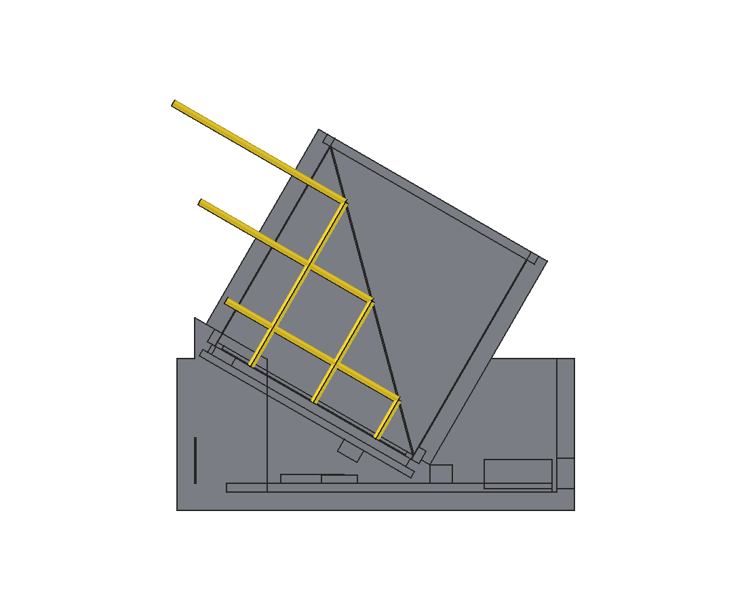
cad/out_v2_tilt30/render/09_剖视_光路.png
