huiyi-li/esp32_show_tv/cad/out_v2_tilt30/render/10_光路_用户视角.png

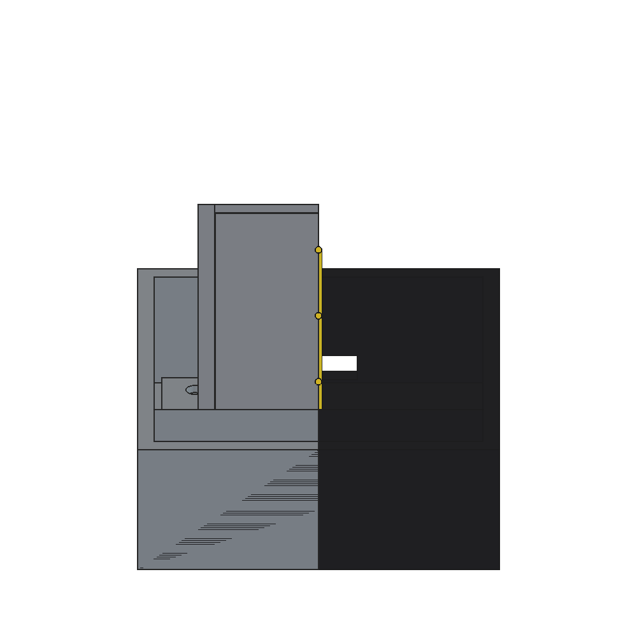
cad/out_v2_tilt30/render/10_光路_用户视角.png
