huiyi-li/esp32_show_tv/cad/out_v2_tilt30/渲染总览.png

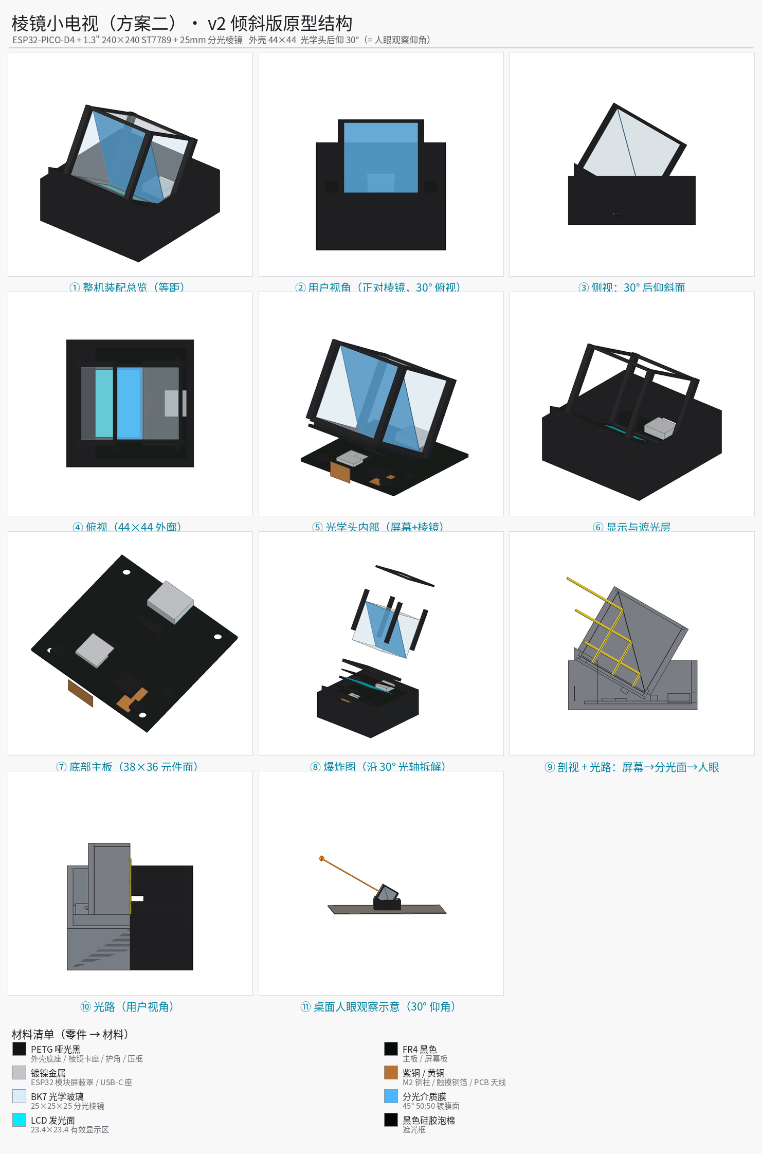
cad/out_v2_tilt30/渲染总览.png
