huiyi-li/esp32_show_tv/firmware/.easyeda/artifacts/20261020-141226-pcb_snapshot-1988acb5.png

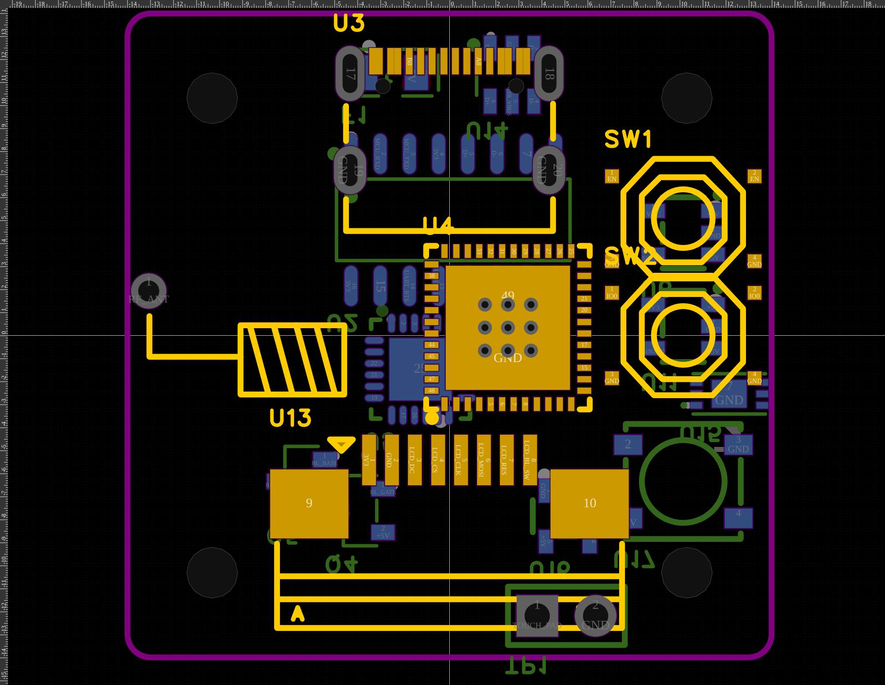
firmware/.easyeda/artifacts/20261020-141226-pcb_snapshot-1988acb5.png
