huiyi-li/esp32_show_tv/firmware/.easyeda/artifacts/20261020-142344-pcb_snapshot-54a026ba.png

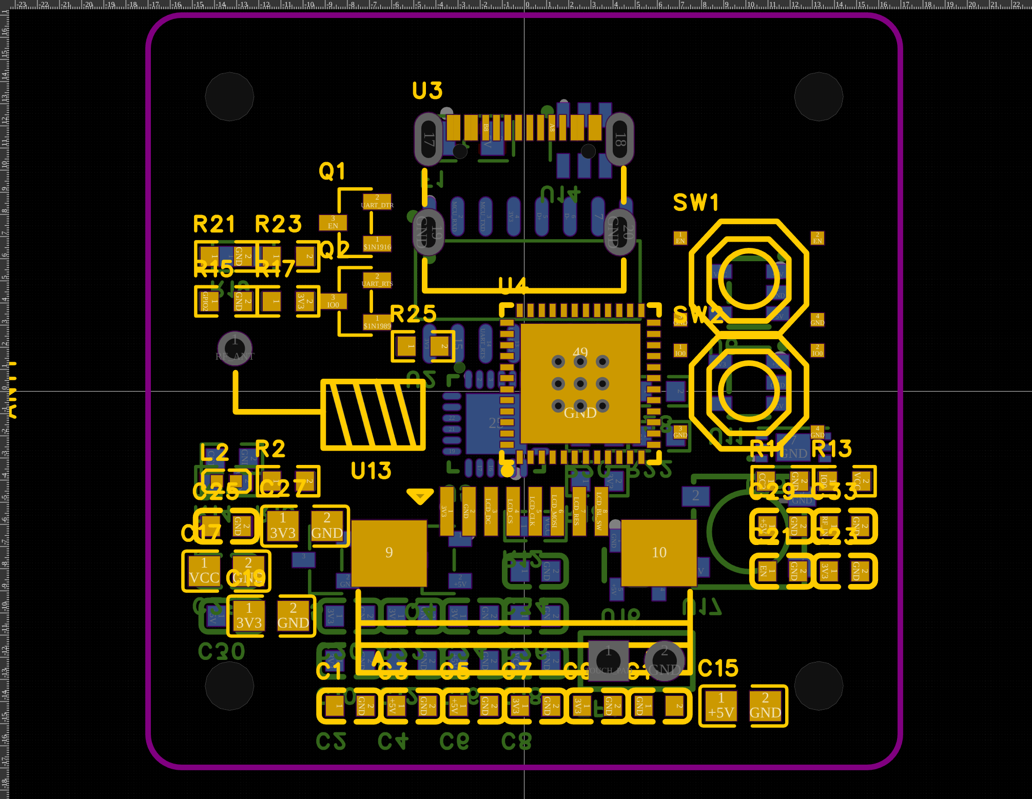
firmware/.easyeda/artifacts/20261020-142344-pcb_snapshot-54a026ba.png
