huiyi-li/esp32_show_tv/firmware/.easyeda/artifacts/20261020-151306-pcb_snapshot-0e91b1fd.png

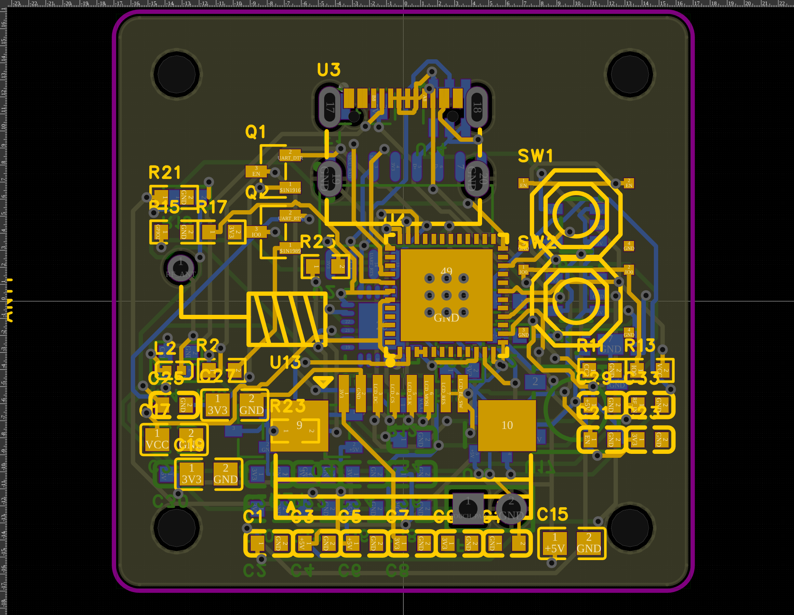
firmware/.easyeda/artifacts/20261020-151306-pcb_snapshot-0e91b1fd.png
