huiyi-li/esp32_show_tv/firmware/.easyeda/artifacts/20261020-165626-pcb_snapshot-d5298d4e.png

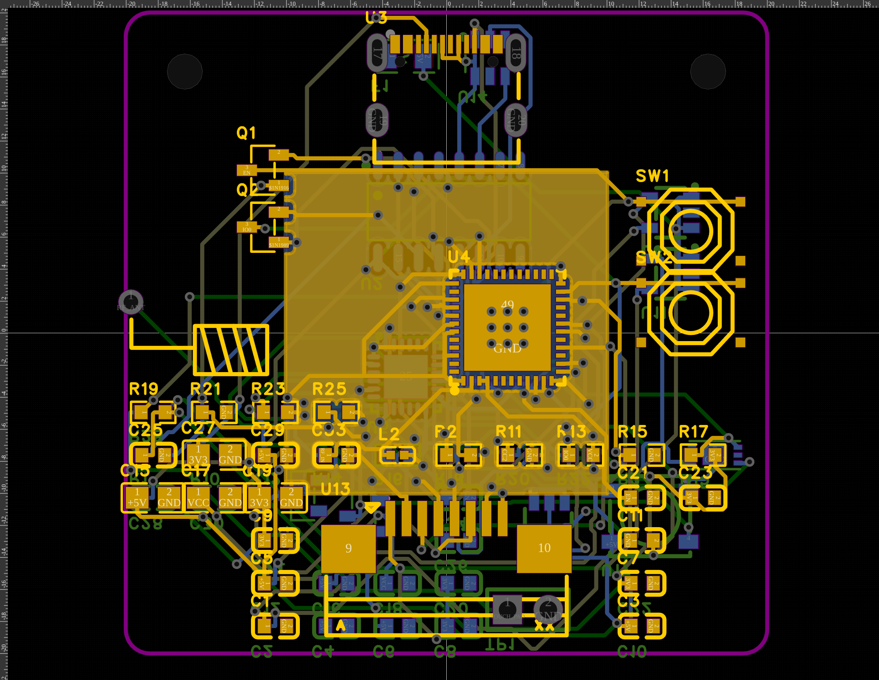
firmware/.easyeda/artifacts/20261020-165626-pcb_snapshot-d5298d4e.png
