huiyi-li/esp32_show_tv/firmware/.easyeda/artifacts/20261020-170046-pcb_snapshot-c2b20c0a.png

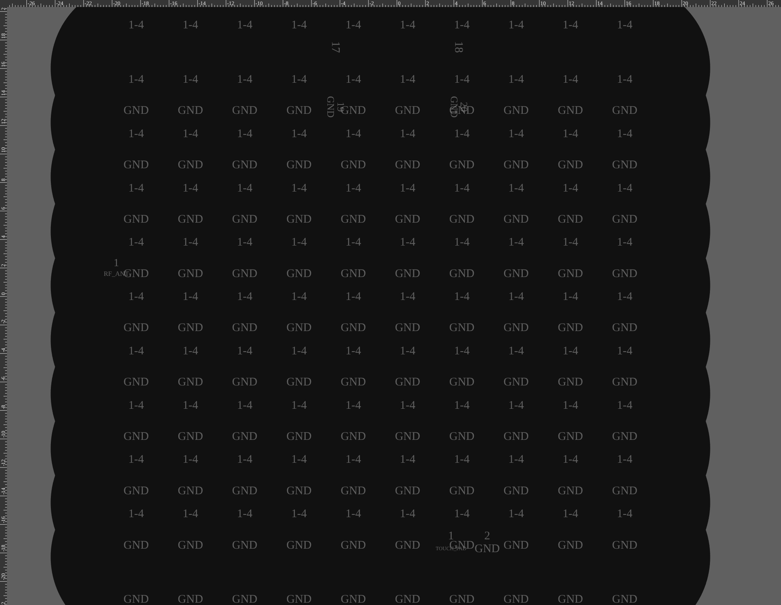
firmware/.easyeda/artifacts/20261020-170046-pcb_snapshot-c2b20c0a.png
