huiyi-li/esp32_show_tv/cad/out/BOM.csv

序号 | 零件 | 材料 | 材料说明 | 尺寸(bbox mm)
1 | 外壳底座 | PETG_Beige | 外壳，暖米白哑光（3D 打印 / 注塑） | 33.0 x 40.0 x 20.7
2 | 主板 | FR4_Dark | PCB，黑色阻焊 FR4 | 28.0 x 28.0 x 1.0
3 | ESP32模块 | Alu_Shield | ESP32 模块屏蔽罩 / USB-C 外壳 | 7.0 x 7.0 x 1.0
4 | PCB天线 | Copper | 触摸铜箔 / PCB 天线 | 4.0 x 8.0 x 0.1
5 | USB_C座 | Alu_Shield | ESP32 模块屏蔽罩 / USB-C 外壳 | 9.0 x 7.5 x 3.2
6 | 连接器12P | Plastic_Black | 连接器 / 按键 / 器件黑色塑封 | 6.0 x 2.5 x 2.0
7 | 轻触键1 | Plastic_Black | 连接器 / 按键 / 器件黑色塑封 | 3.0 x 2.5 x 1.5
8 | 轻触键2 | Plastic_Black | 连接器 / 按键 / 器件黑色塑封 | 3.0 x 2.5 x 1.5
9 | MPU6050 | Plastic_Black | 连接器 / 按键 / 器件黑色塑封 | 4.0 x 4.0 x 0.9
10 | BH1750 | Plastic_Black | 连接器 / 按键 / 器件黑色塑封 | 2.6 x 2.4 x 0.9
11 | 电源模块 | Plastic_Black | 连接器 / 按键 / 器件黑色塑封 | 6.0 x 5.0 x 1.5
12 | 触摸铜箔 | Copper | 触摸铜箔 / PCB 天线 | 0.1 x 9.0 x 3.0
13 | 后支撑1 | Copper | 触摸铜箔 / PCB 天线 | 5.0 x 5.0 x 0.6
14 | 后支撑2 | Copper | 触摸铜箔 / PCB 天线 | 5.0 x 5.0 x 0.6
15 | 屏幕板 | FR4_Dark | PCB，黑色阻焊 FR4 | 28.0 x 24.6 x 14.7
16 | FPC座 | Plastic_Black | 连接器 / 按键 / 器件黑色塑封 | 10.0 x 2.6 x 1.9
17 | 显示面板 | LCD_Glass | 1.3" 240x240 IPS 面板玻璃 | 24.8 x 22.0 x 13.3
18 | 显示发光面 | LCD_Emissive | 显示发光面（示意） | 23.4 x 20.3 x 11.8
19 | 遮光框 | Silicone_Black | 黑色遮光框 | 25.4 x 22.2 x 13.1
20 | 光学胶 | UV_Glue | UV 光学胶（棱镜粘接） | 25.4 x 22.0 x 12.8
21 | 分光棱镜 | BK7_Glass | 分光棱镜本体，BK7 光学玻璃 | 25.4 x 34.7 x 34.7
22 | 分光膜 | Coating_Half | 45° 50:50 分光介质膜 | 25.4 x 9.4 x 34.7
