huiyi-li/esp32_show_tv/cad/out_v2_tilt30/BOM.csv

序号 | 零件 | 材料 | 材料说明 | 尺寸(bbox mm)
1 | 外壳底座 | PETG_Matt_Black | 外壳/卡座/压框/护角，哑光黑 3D 打印 | 44.0 x 44.0 x 21.3
2 | 主板 | FR4_Dark | PCB，黑色阻焊 FR4 | 38.0 x 36.0 x 1.0
3 | ESP32模块 | Alu_Shield | ESP32 模块屏蔽罩 / USB-C 外壳，镀镍金属 | 7.0 x 7.0 x 1.0
4 | PCB天线 | Copper | M2 铜柱 / 触摸铜箔 / PCB 天线 | 4.0 x 8.0 x 0.1
5 | USB_C座 | Alu_Shield | ESP32 模块屏蔽罩 / USB-C 外壳，镀镍金属 | 9.0 x 7.5 x 3.2
6 | 连接器14P | Plastic_Black | 连接器 / 轻触键 / 器件黑色塑封 | 7.0 x 2.5 x 2.0
7 | 轻触键1 | Plastic_Black | 连接器 / 轻触键 / 器件黑色塑封 | 3.0 x 2.5 x 1.5
8 | 轻触键2 | Plastic_Black | 连接器 / 轻触键 / 器件黑色塑封 | 3.0 x 2.5 x 1.5
9 | MPU6050 | Plastic_Black | 连接器 / 轻触键 / 器件黑色塑封 | 4.0 x 4.0 x 0.9
10 | BH1750 | Plastic_Black | 连接器 / 轻触键 / 器件黑色塑封 | 2.6 x 2.4 x 0.9
11 | 电源模块 | Plastic_Black | 连接器 / 轻触键 / 器件黑色塑封 | 6.0 x 5.0 x 1.5
12 | 触摸铜箔 | Copper | M2 铜柱 / 触摸铜箔 / PCB 天线 | 8.0 x 0.1 x 5.0
13 | 屏幕板 | FR4_Dark | PCB，黑色阻焊 FR4 | 27.0 x 23.8 x 14.2
14 | FPC座 | Plastic_Black | 连接器 / 轻触键 / 器件黑色塑封 | 11.0 x 3.1 x 2.4
15 | 连接器14P_公 | Plastic_Black | 连接器 / 轻触键 / 器件黑色塑封 | 7.0 x 2.9 x 2.5
16 | 显示面板 | LCD_Glass | 1.3" 240x240 IPS 面板玻璃 | 24.8 x 22.0 x 13.3
17 | 显示发光面 | LCD_Emissive | 显示发光面（示意） | 23.4 x 20.3 x 11.8
18 | 遮光框 | Silicone_Black | 遮光框黑色硅胶/泡棉 | 25.0 x 21.9 x 12.9
19 | 分光棱镜 | BK7_Glass | 分光棱镜本体，BK7 光学玻璃 | 25.0 x 34.2 x 34.2
20 | 分光膜 | Coating_Half | 45° 50:50 分光介质膜 | 25.0 x 9.3 x 34.2
21 | 棱镜卡座 | PETG_Matt_Black | 外壳/卡座/压框/护角，哑光黑 3D 打印 | 27.0 x 24.2 x 14.9
22 | 棱镜护角1 | PETG_Matt_Black | 外壳/卡座/压框/护角，哑光黑 3D 打印 | 2.0 x 14.7 x 23.5
23 | 棱镜护角2 | PETG_Matt_Black | 外壳/卡座/压框/护角，哑光黑 3D 打印 | 2.0 x 14.7 x 23.5
24 | 棱镜护角3 | PETG_Matt_Black | 外壳/卡座/压框/护角，哑光黑 3D 打印 | 2.0 x 14.7 x 23.5
25 | 棱镜护角4 | PETG_Matt_Black | 外壳/卡座/压框/护角，哑光黑 3D 打印 | 2.0 x 14.7 x 23.5
26 | 顶部压框 | PETG_Matt_Black | 外壳/卡座/压框/护角，哑光黑 3D 打印 | 27.0 x 23.9 x 14.4
