huiyi-li/esp32_show_tv/cad/out/PrismTV_Assembly.step

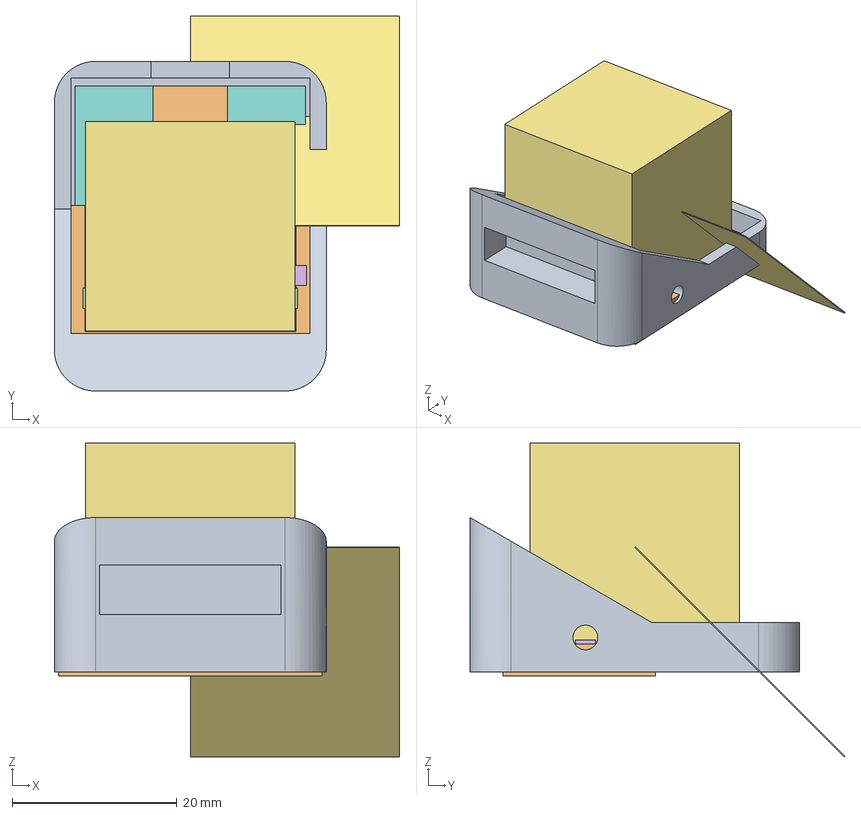
[picture p36: CAD file, 2026-10-30]
cad/out/PrismTV_Assembly.step
41.9 x 45.5 x 38.1 mm
