huiyi-li/esp32_show_tv/cad/out/PrismTV_v3_wedge.step

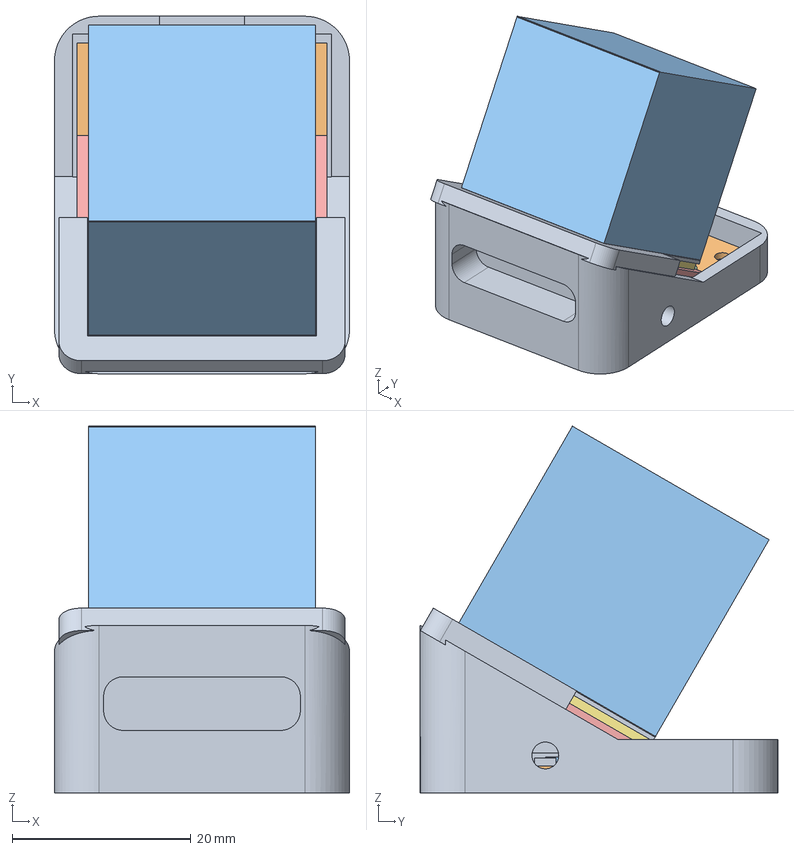
[picture p37: CAD file, 2026-10-30]
cad/out/PrismTV_v3_wedge.step
33.0 x 40.0 x 41.0 mm
