huiyi-li/esp32_show_tv/cad/out/stl/连接器12P.stl

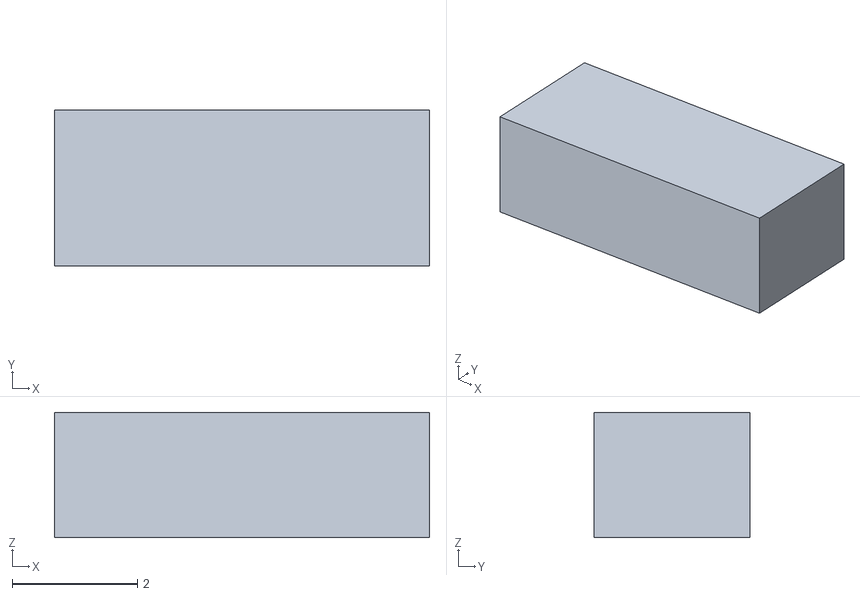
[picture p38: CAD file, 2026-10-30]
cad/out/stl/连接器12P.stl
6.00 x 2.50 x 2.00
