huiyi-li/esp32_show_tv/cad/out_v1_vertical/PrismTV_Prototype_v1.step

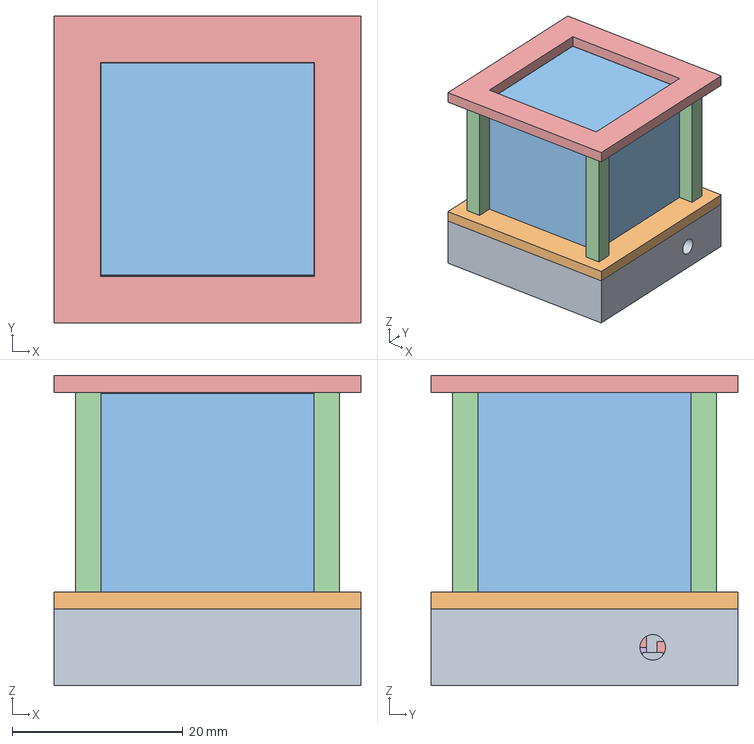
[picture p39: CAD file, 2026-10-30]
cad/out_v1_vertical/PrismTV_Prototype_v1.step
36.0 x 36.0 x 36.4 mm
