huiyi-li/esp32_show_tv/cad/out_v1_vertical/stl/ESP32模块.stl

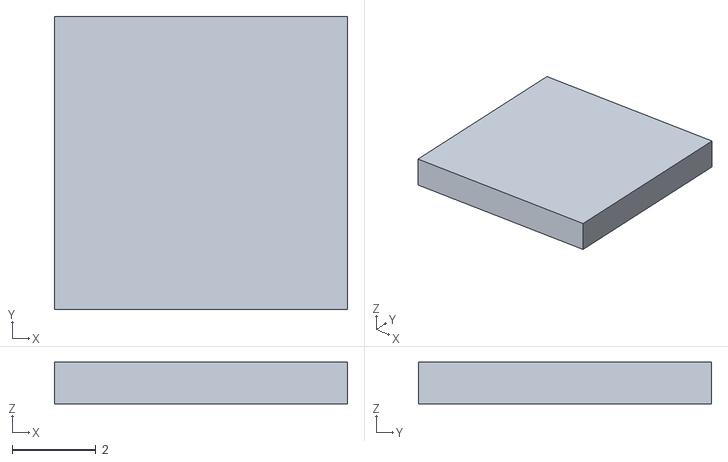
[picture p40: CAD file, 2026-10-30]
cad/out_v1_vertical/stl/ESP32模块.stl
7.00 x 7.00 x 1.00
