huiyi-li/esp32_show_tv/cad/out_v2_tilt30/PrismTV_v2_tilt30.step

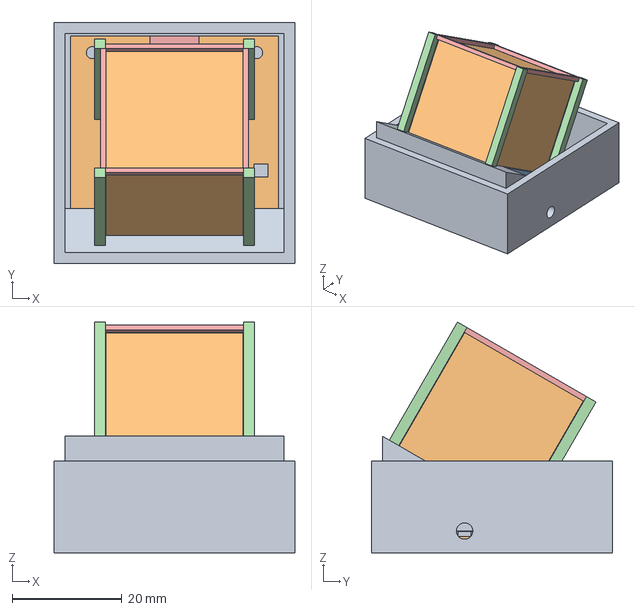
[picture p41: CAD file, 2026-10-30]
cad/out_v2_tilt30/PrismTV_v2_tilt30.step
44.0 x 44.0 x 42.2 mm
