huiyi-li/esp32_show_tv/cad/out_v2_tilt30/stl/FPC座.stl

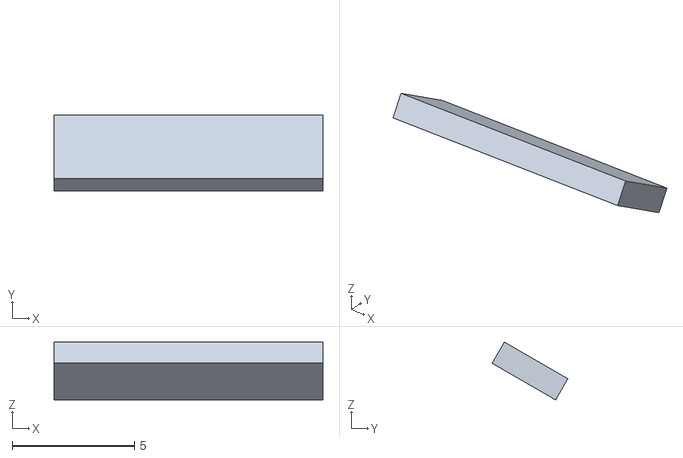
[picture p42: CAD file, 2026-10-30]
cad/out_v2_tilt30/stl/FPC座.stl
11.0 x 3.10 x 2.37
