huiyi-li/esp32_show_tv/cad/solidcraft/prismtv.step

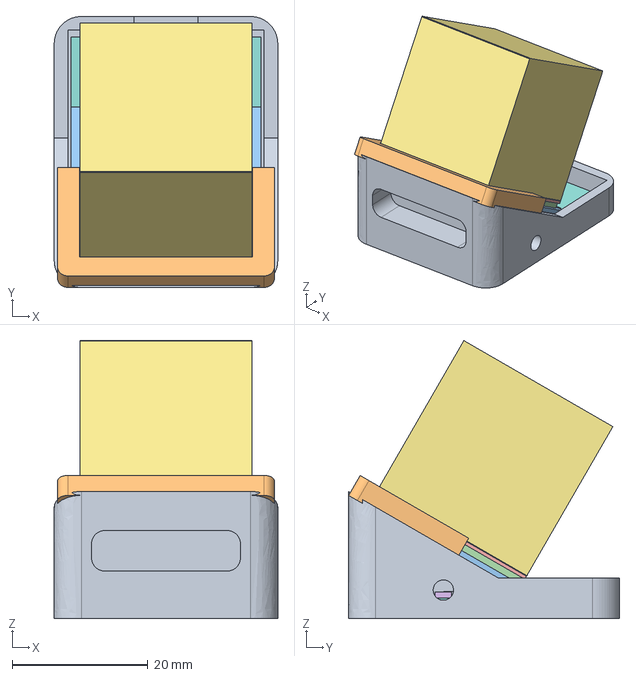
[picture p43: CAD file, 2026-10-30]
cad/solidcraft/prismtv.step
33.0 x 40.0 x 41.0 mm
