huiyi-li/esp32_show_tv/cad/out/stl/显示面板.stl

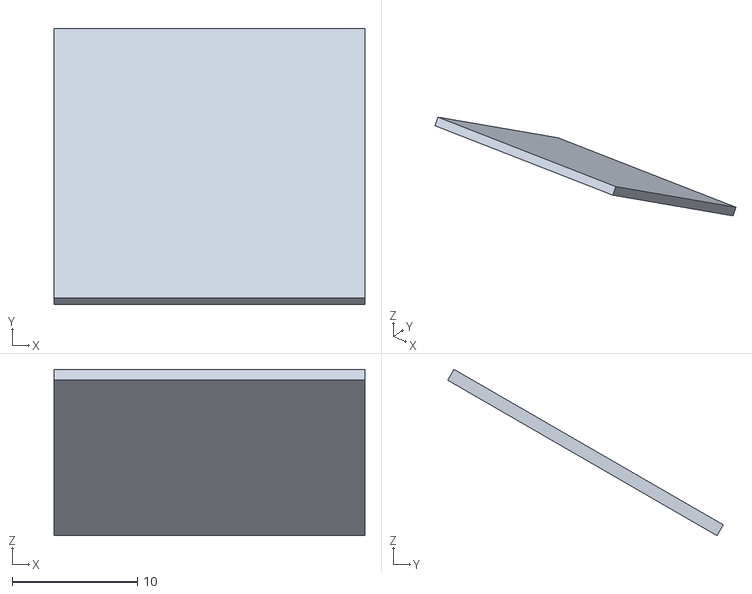
[picture p44: CAD file, 2026-10-30]
cad/out/stl/显示面板.stl
24.8 x 22.0 x 13.3
