huiyi-li/esp32_show_tv/cad/out_v1_vertical/stl/轻触键1.stl

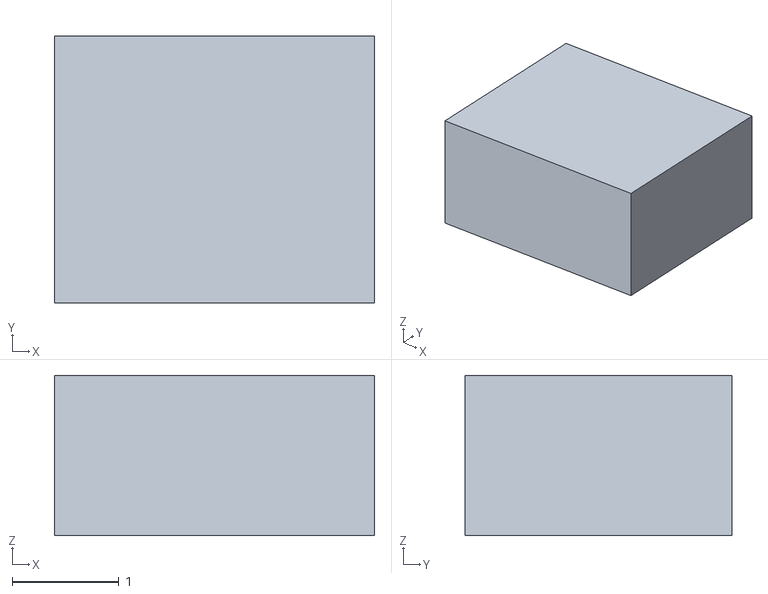
[picture p45: CAD file, 2026-10-30]
cad/out_v1_vertical/stl/轻触键1.stl
3.00 x 2.50 x 1.50
