huiyi-li/esp32_show_tv/cad/out_v1_vertical/stl/棱镜护角1.stl

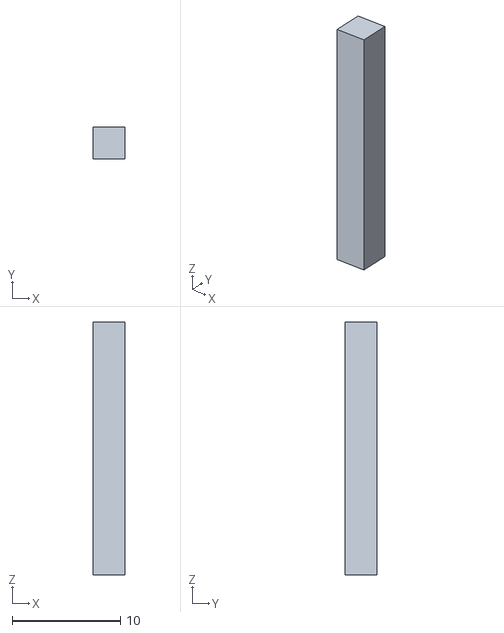
[picture p46: CAD file, 2026-10-30]
cad/out_v1_vertical/stl/棱镜护角1.stl
3.00 x 3.00 x 23.4
