huiyi-li/esp32_show_tv/cad/out_v2_tilt30/stl/分光膜.stl

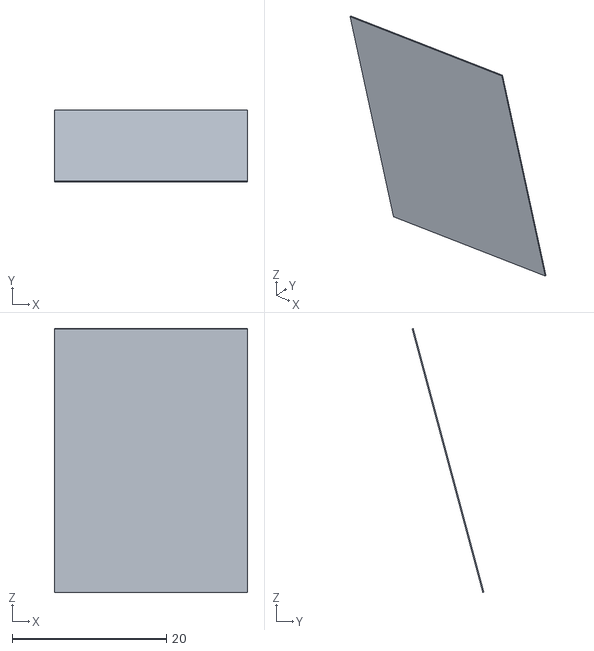
[picture p47: CAD file, 2026-10-30]
cad/out_v2_tilt30/stl/分光膜.stl
25.0 x 9.30 x 34.2
