huiyi-li/esp32_show_tv/cad/out_v1_vertical/stl/MPU6050.stl

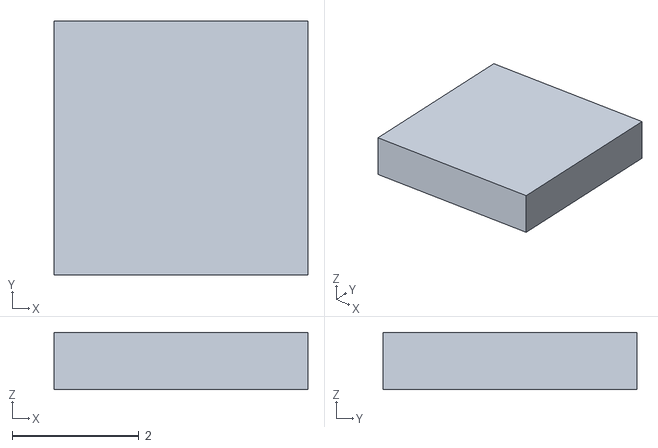
[picture p48: CAD file, 2026-10-30]
cad/out_v1_vertical/stl/MPU6050.stl
4.00 x 4.00 x 0.9
