huiyi-li/esp32_show_tv/cad/out/stl/FPC座.stl

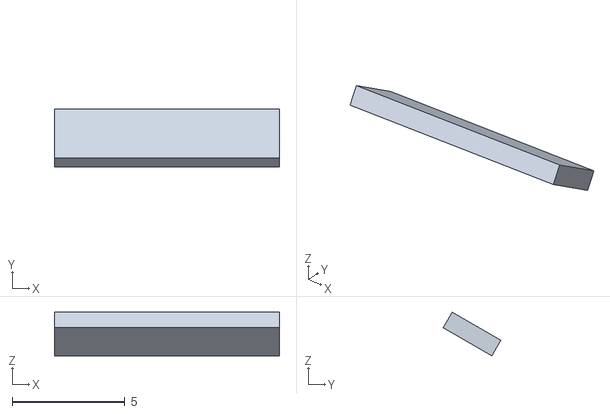
[picture p49: CAD file, 2026-10-30]
cad/out/stl/FPC座.stl
10.0 x 2.57 x 1.94
