huiyi-li/esp32_show_tv/cad/out_v1_vertical/stl/支撑柱1.stl

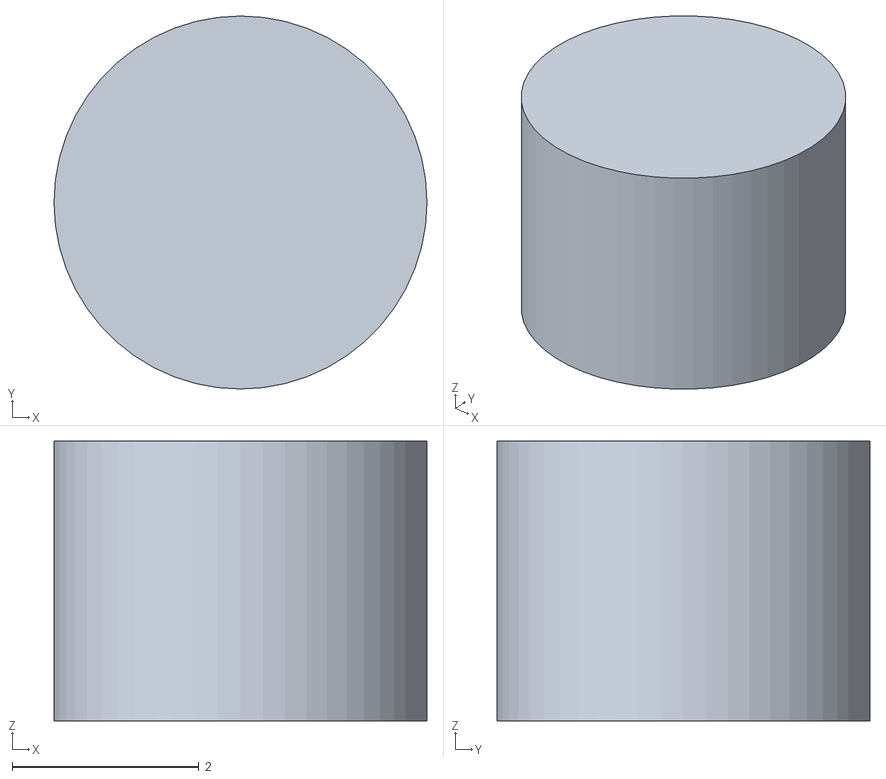
[picture p50: CAD file, 2026-10-30]
cad/out_v1_vertical/stl/支撑柱1.stl
4.00 x 4.00 x 3.00
