huiyi-li/esp32_show_tv/cad/out_v2_tilt30/stl/连接器14P.stl

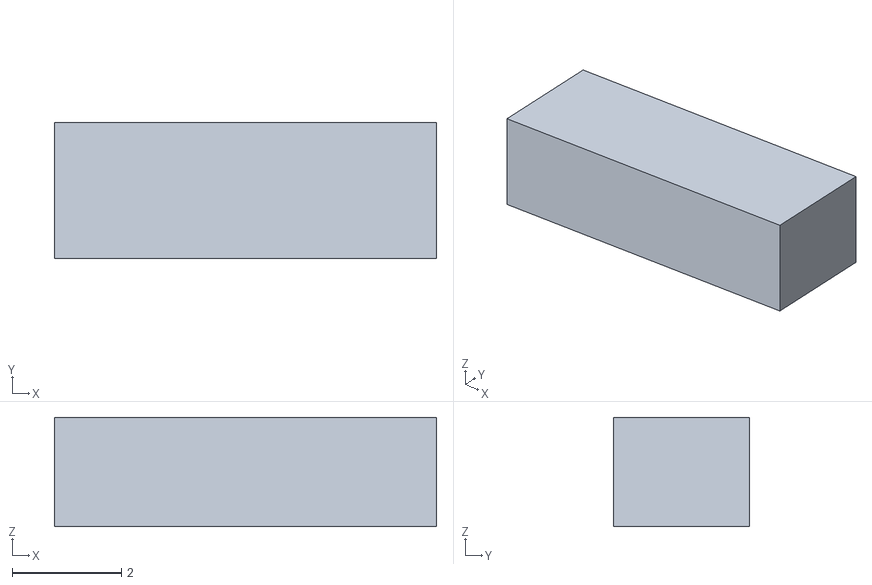
[picture p51: CAD file, 2026-10-30]
cad/out_v2_tilt30/stl/连接器14P.stl
7.00 x 2.50 x 2.00
