huiyi-li/esp32_show_tv/cad/out/stl/C02_USB-C_16P.stl

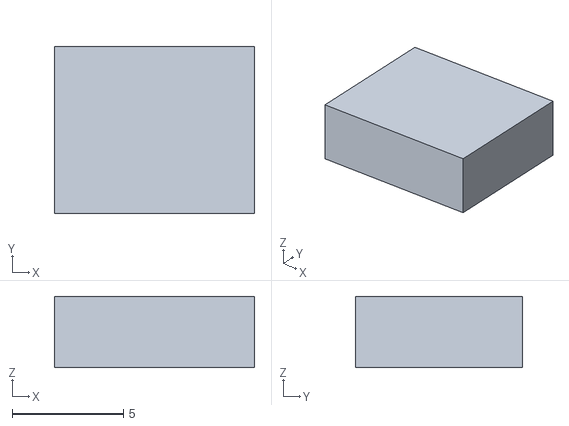
[picture p52: CAD file, 2026-10-30]
cad/out/stl/C02_USB-C_16P.stl
9.00 x 7.50 x 3.20
