huiyi-li/esp32_show_tv/cad/out/stl/C11_后支撑柱.stl

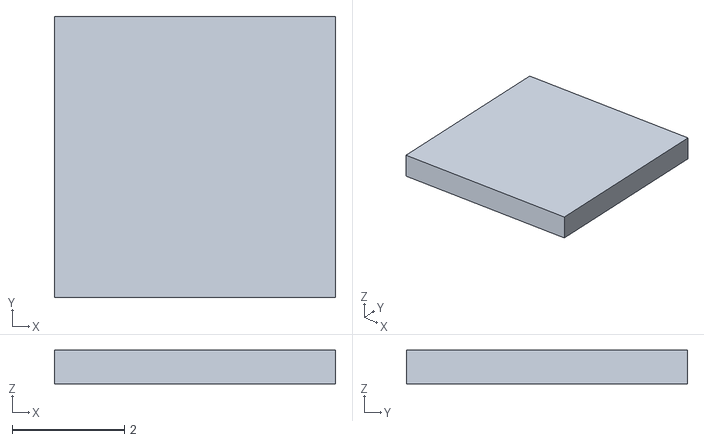
[picture p53: CAD file, 2026-10-30]
cad/out/stl/C11_后支撑柱.stl
5.00 x 5.00 x 0.6
