huiyi-li/esp32_show_tv/cad/out/stl/P02_棱镜托台.stl

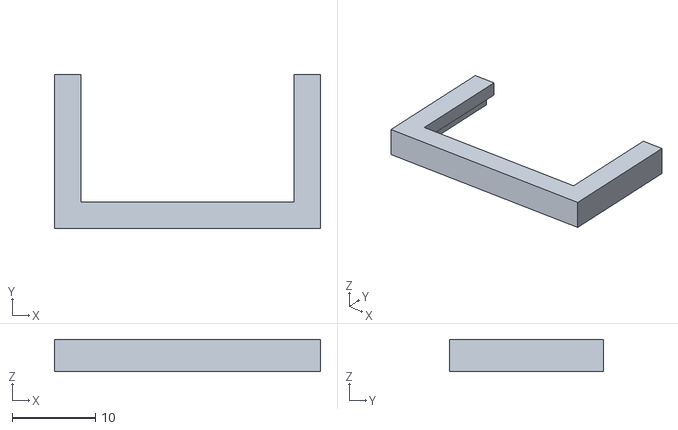
[picture p54: CAD file, 2026-10-30]
cad/out/stl/P02_棱镜托台.stl
32.0 x 18.5 x 3.90
