huiyi-li/esp32_show_tv/cad/out_v1_vertical/stl/BH1750.stl

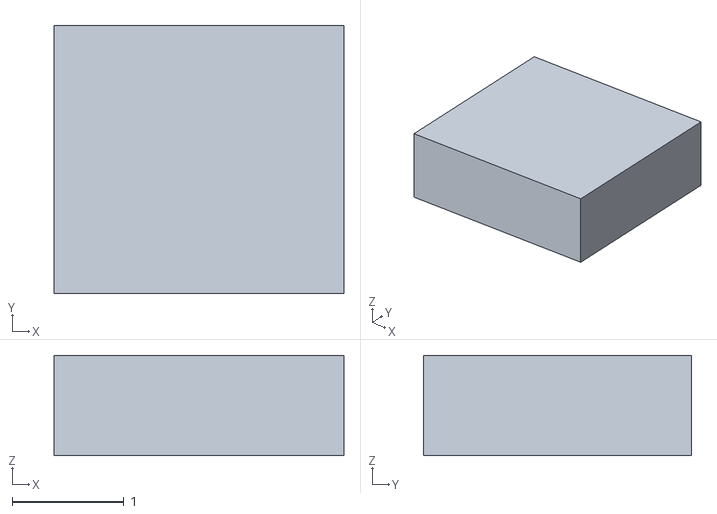
[picture p55: CAD file, 2026-10-30]
cad/out_v1_vertical/stl/BH1750.stl
2.60 x 2.40 x 0.9
