huiyi-li/esp32_show_tv/cad/out/stl/显示发光面.stl

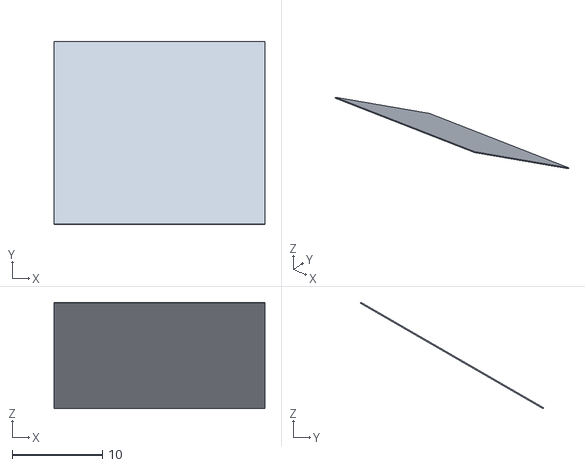
[picture p56: CAD file, 2026-10-30]
cad/out/stl/显示发光面.stl
23.4 x 20.3 x 11.8
