huiyi-li/esp32_show_tv/cad/out_v1_vertical/stl/PCB天线.stl

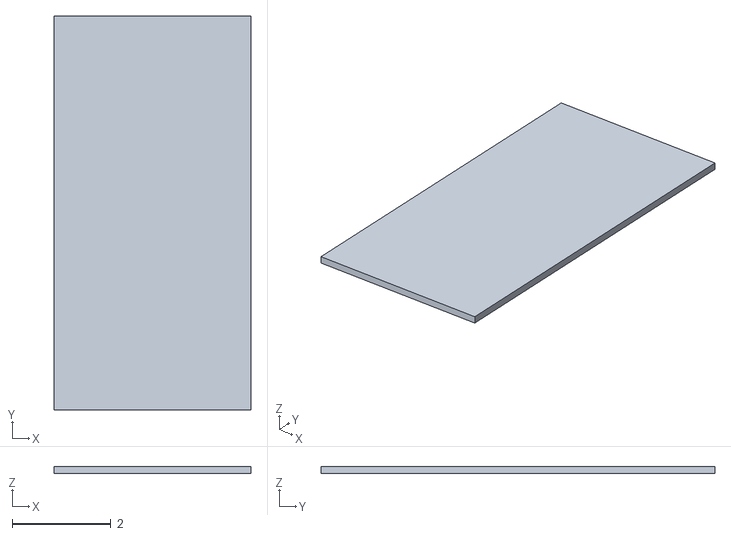
[picture p57: CAD file, 2026-10-30]
cad/out_v1_vertical/stl/PCB天线.stl
4.00 x 8.00 x 0.15
