huiyi-li/esp32_show_tv/cad/out_v2_tilt30/stl/棱镜护角4.stl

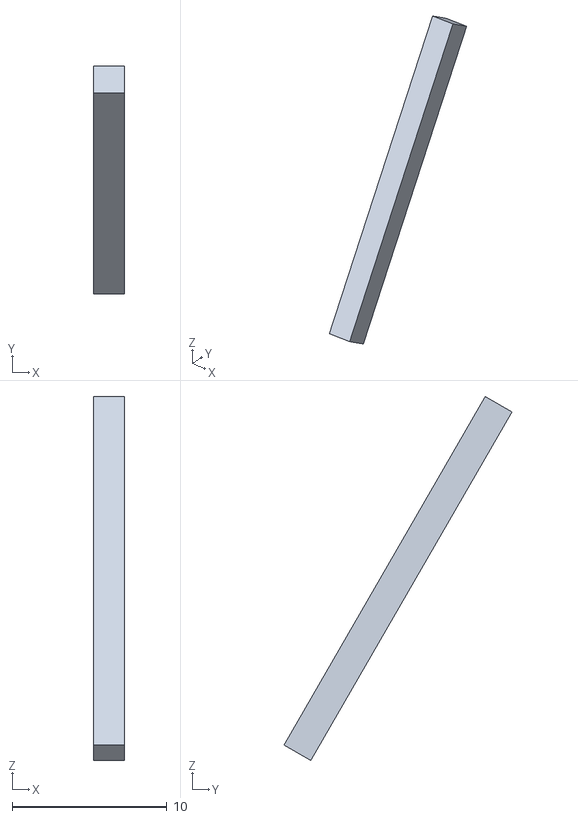
[picture p58: CAD file, 2026-10-30]
cad/out_v2_tilt30/stl/棱镜护角4.stl
2.00 x 14.7 x 23.5
