huiyi-li/esp32_show_tv/cad/out_v1_vertical/stl/顶部压框.stl

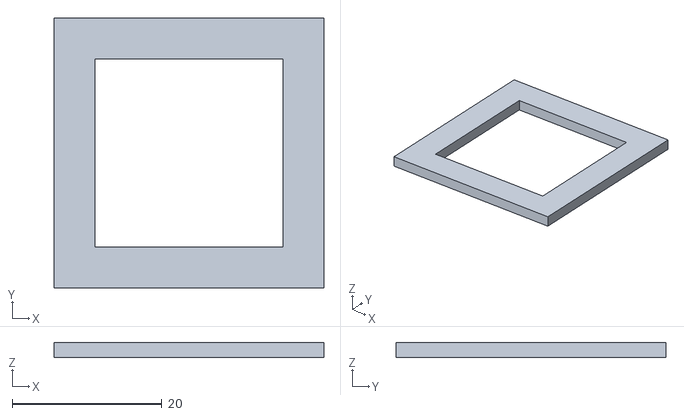
[picture p59: CAD file, 2026-10-30]
cad/out_v1_vertical/stl/顶部压框.stl
36.0 x 36.0 x 2.00
