huiyi-li/esp32_show_tv/cad/out_v2_tilt30/stl/棱镜卡座.stl

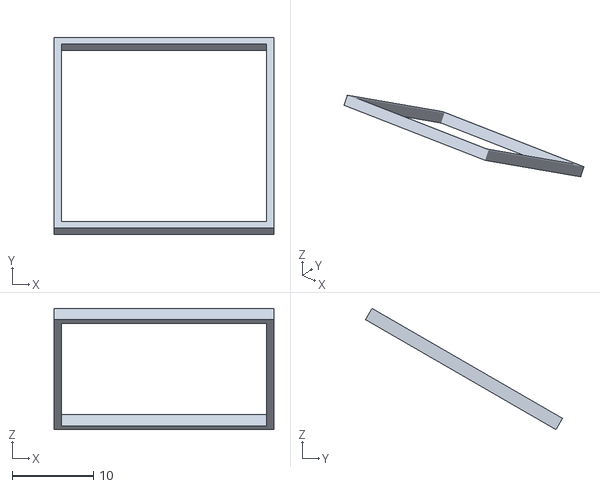
[picture p60: CAD file, 2026-10-30]
cad/out_v2_tilt30/stl/棱镜卡座.stl
27.0 x 24.2 x 14.9
