huiyi-li/esp32_show_tv/cad/out/stl/光学胶.stl

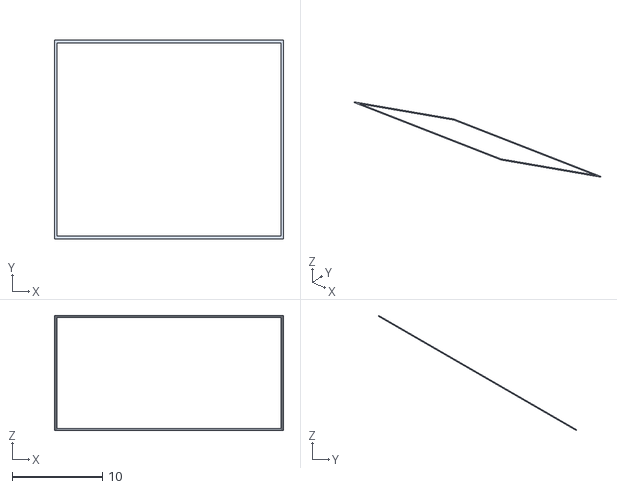
[picture p61: CAD file, 2026-10-30]
cad/out/stl/光学胶.stl
25.4 x 22.0 x 12.8
