huiyi-li/esp32_show_tv/cad/out_v1_vertical/stl/显示面板.stl

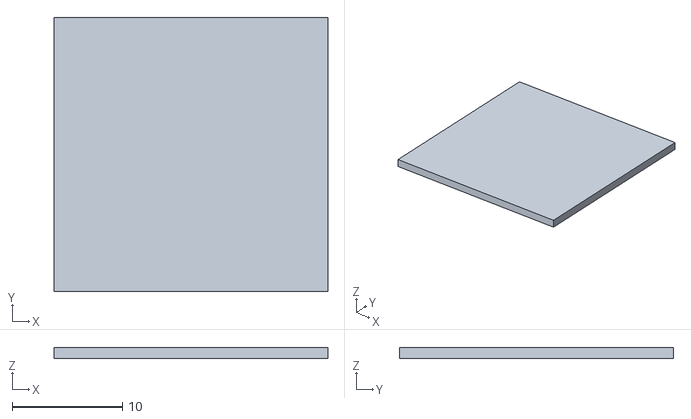
[picture p62: CAD file, 2026-10-30]
cad/out_v1_vertical/stl/显示面板.stl
24.8 x 24.8 x 1.00
