huiyi-li/esp32_show_tv/cad/out_v2_tilt30/stl/连接器14P_公.stl

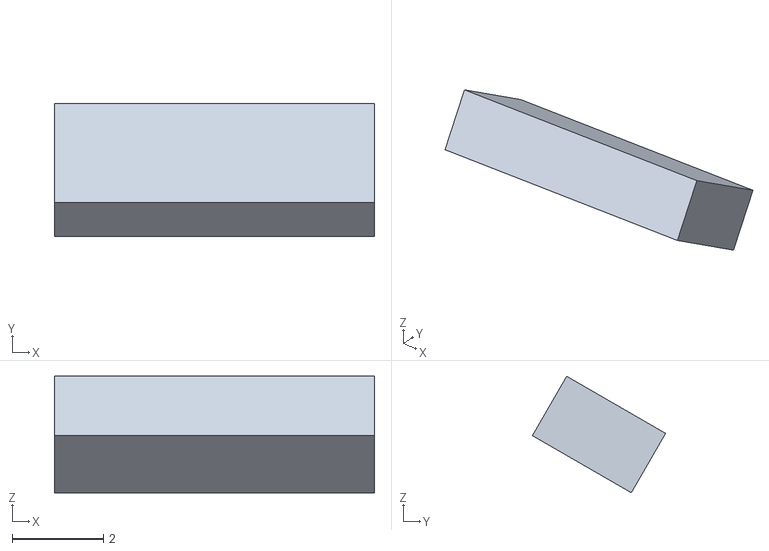
[picture p63: CAD file, 2026-10-30]
cad/out_v2_tilt30/stl/连接器14P_公.stl
7.00 x 2.92 x 2.55
