huiyi-li/esp32_show_tv/cad/out_v1_vertical/stl/遮光框.stl

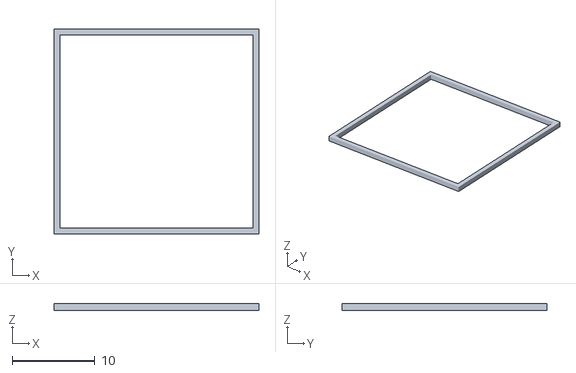
[picture p64: CAD file, 2026-10-30]
cad/out_v1_vertical/stl/遮光框.stl
24.8 x 24.8 x 0.8
