huiyi-li/esp32_show_tv/cad/out_v2_tilt30/stl/触摸铜箔.stl

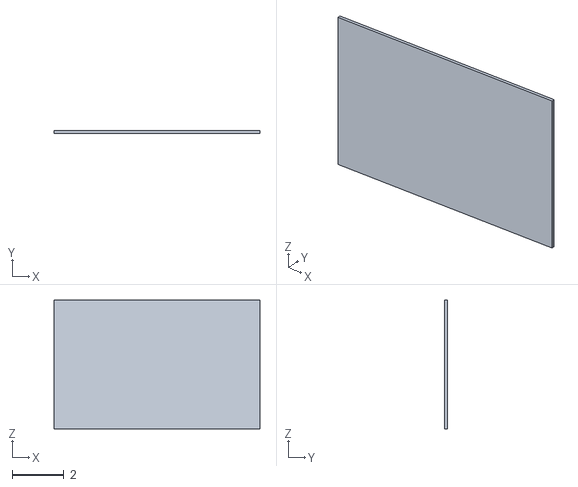
[picture p65: CAD file, 2026-10-30]
cad/out_v2_tilt30/stl/触摸铜箔.stl
8.00 x 0.1 x 5.00
