huiyi-li/esp32_show_tv/cad/out_v1_vertical/stl/分光膜.stl

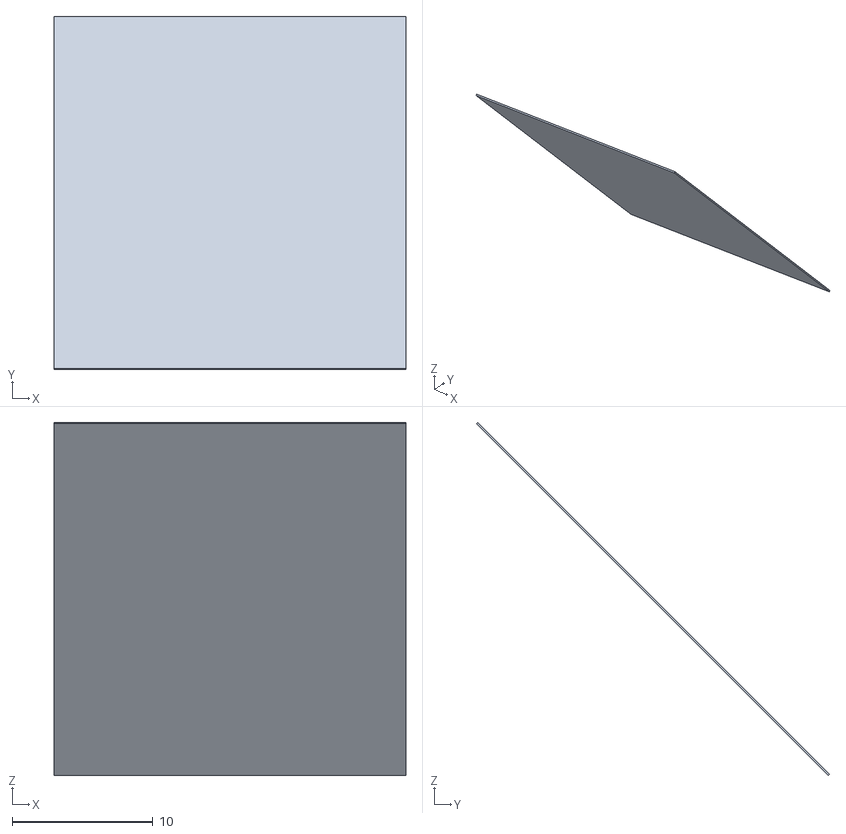
[picture p66: CAD file, 2026-10-30]
cad/out_v1_vertical/stl/分光膜.stl
25.0 x 25.1 x 25.1
