huiyi-li/esp32_show_tv/cad/out_v2_tilt30/stl/顶部压框.stl

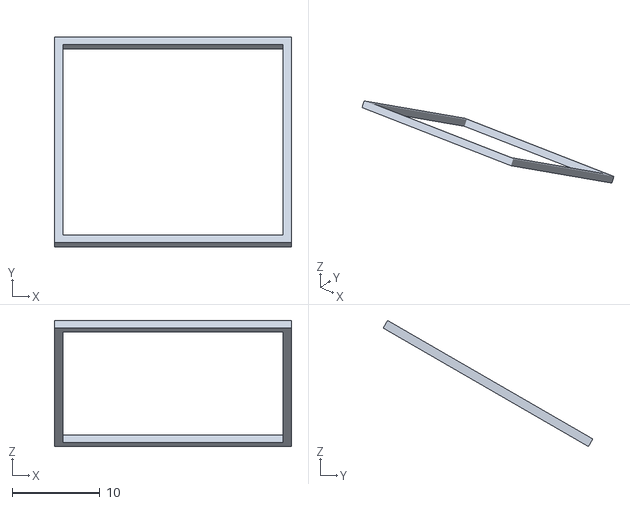
[picture p67: CAD file, 2026-10-30]
cad/out_v2_tilt30/stl/顶部压框.stl
27.0 x 23.9 x 14.4
