huiyi-li/esp32_show_tv/cad/out_v1_vertical/stl/分光棱镜.stl

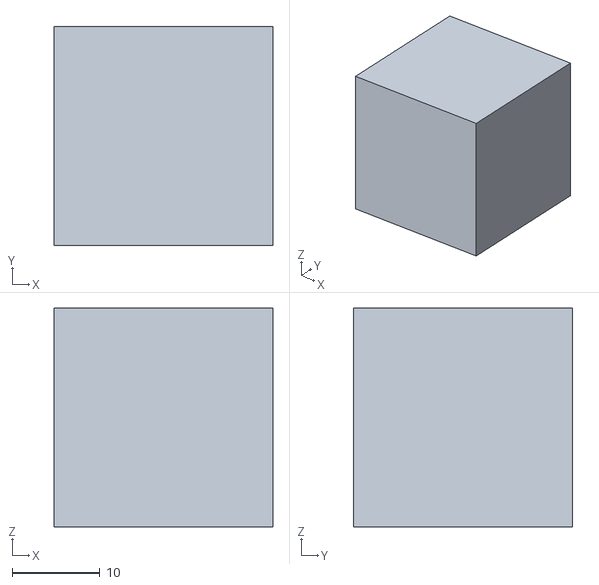
[picture p68: CAD file, 2026-10-30]
cad/out_v1_vertical/stl/分光棱镜.stl
25.0 x 25.0 x 25.0
