huiyi-li/esp32_show_tv/cad/out/stl/P05_遮光框.stl

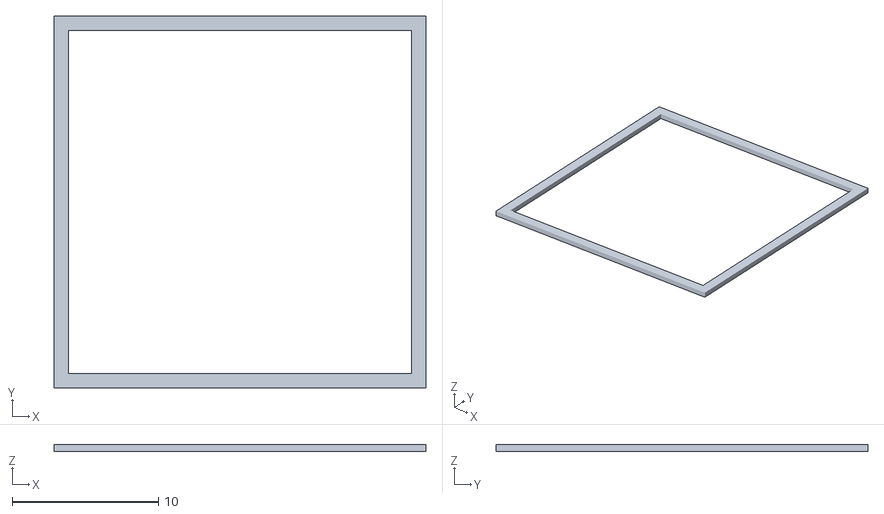
[picture p69: CAD file, 2026-10-30]
cad/out/stl/P05_遮光框.stl
25.4 x 25.4 x 0.5
