huiyi-li/esp32_show_tv/cad/out_v1_vertical/stl/主板.stl

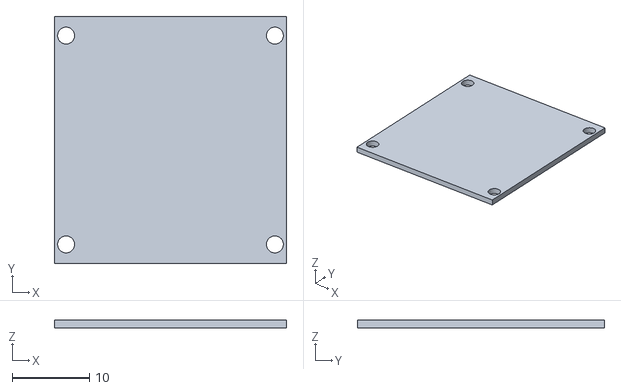
[picture p70: CAD file, 2026-10-30]
cad/out_v1_vertical/stl/主板.stl
30.0 x 32.0 x 1.00
