huiyi-li/esp32_show_tv/cad/out_v2_tilt30/stl/外壳底座.stl

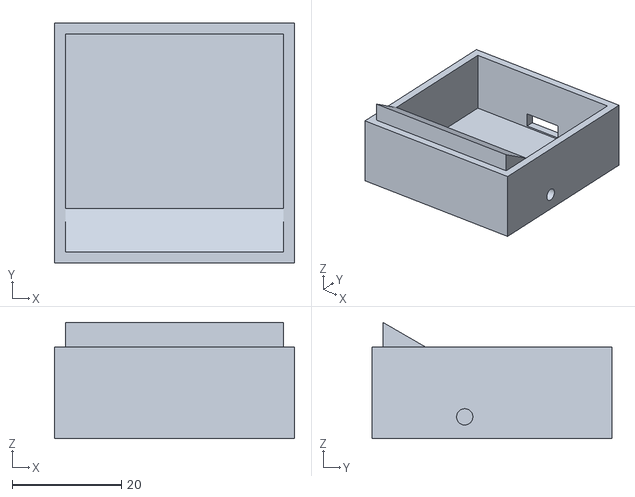
[picture p71: CAD file, 2026-10-30]
cad/out_v2_tilt30/stl/外壳底座.stl
44.0 x 44.0 x 21.3
