huiyi-li/esp32_show_tv/cad/out/stl/P06_光学胶.stl

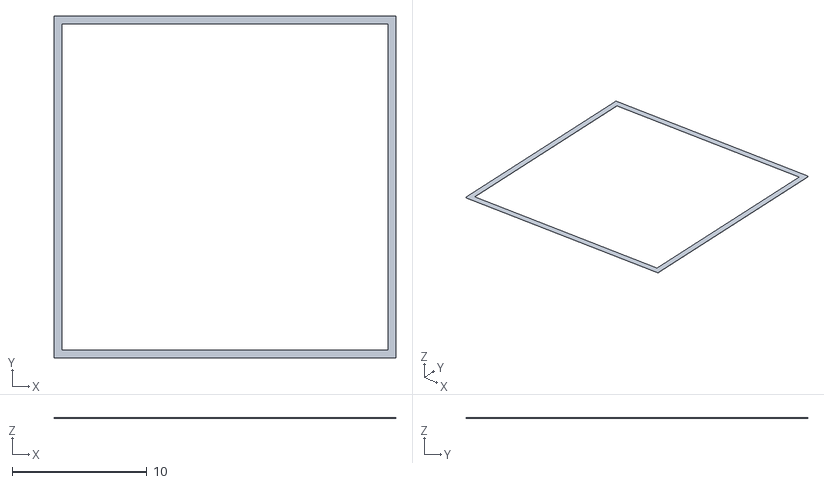
[picture p72: CAD file, 2026-10-30]
cad/out/stl/P06_光学胶.stl
25.4 x 25.4 x 0.1
