huiyi-li/esp32_show_tv/cad/out/stl/P08_分光膜.stl

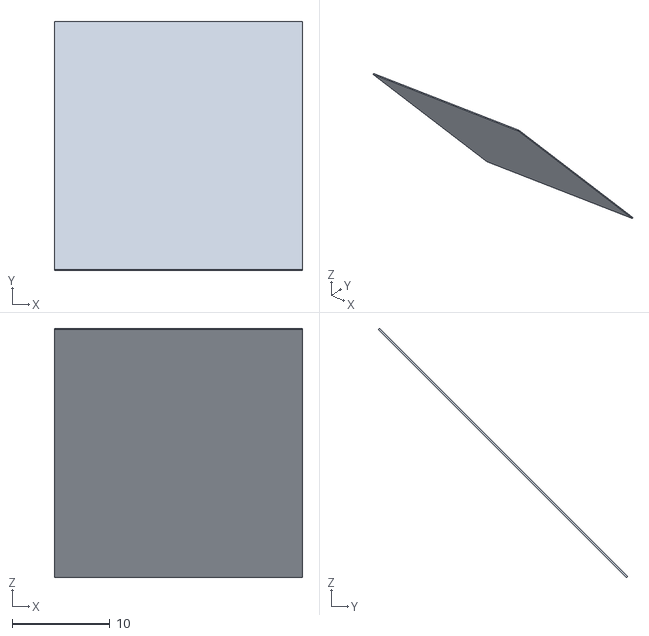
[picture p73: CAD file, 2026-10-30]
cad/out/stl/P08_分光膜.stl
25.4 x 25.5 x 25.5
