huiyi-li/esp32_show_tv/cad/out_v1_vertical/stl/屏幕板.stl

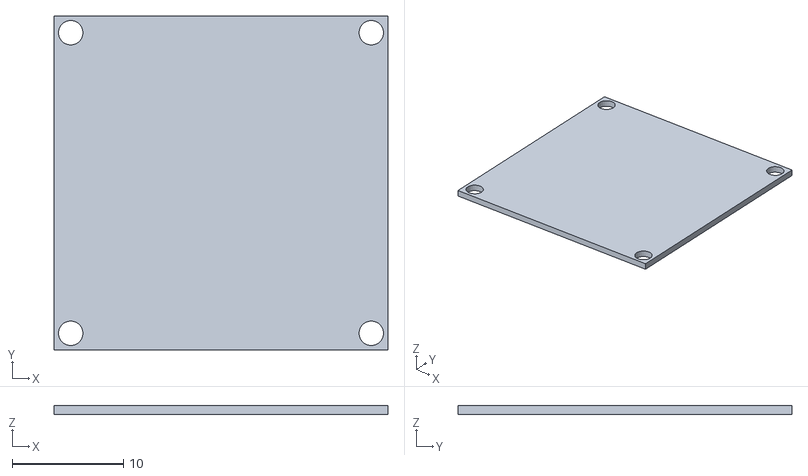
[picture p74: CAD file, 2026-10-30]
cad/out_v1_vertical/stl/屏幕板.stl
30.0 x 30.0 x 0.8
