huiyi-li/esp32_show_tv/cad/out/stl/P07_分光棱镜.stl

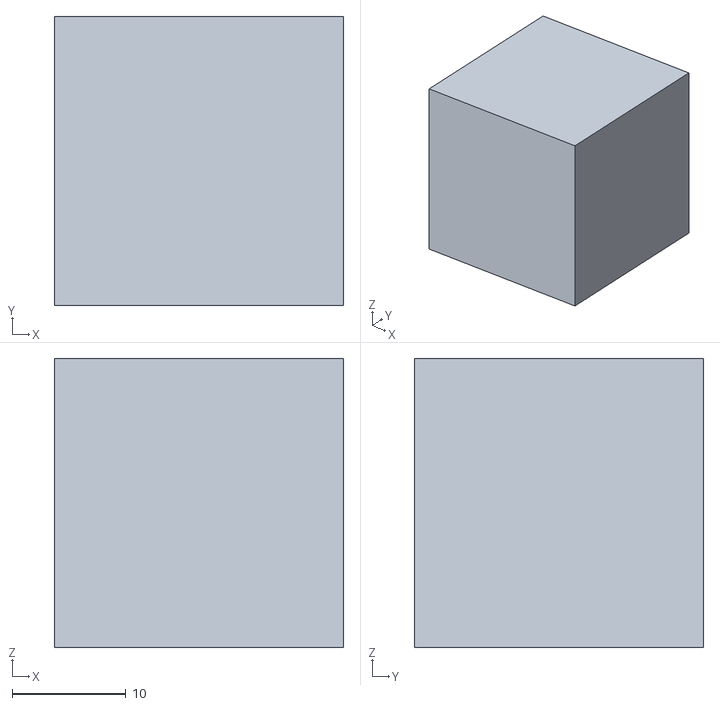
[picture p75: CAD file, 2026-10-30]
cad/out/stl/P07_分光棱镜.stl
25.4 x 25.4 x 25.4
