huiyi-li/esp32_show_tv/cad/out_v1_vertical/stl/显示发光面.stl

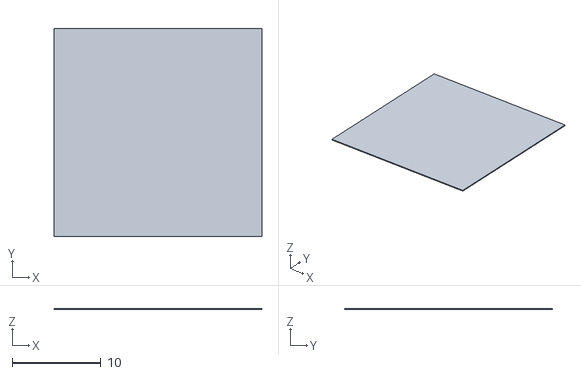
[picture p76: CAD file, 2026-10-30]
cad/out_v1_vertical/stl/显示发光面.stl
23.4 x 23.4 x 0.12
