huiyi-li/esp32_show_tv/cad/out_v2_tilt30/stl/屏幕板.stl

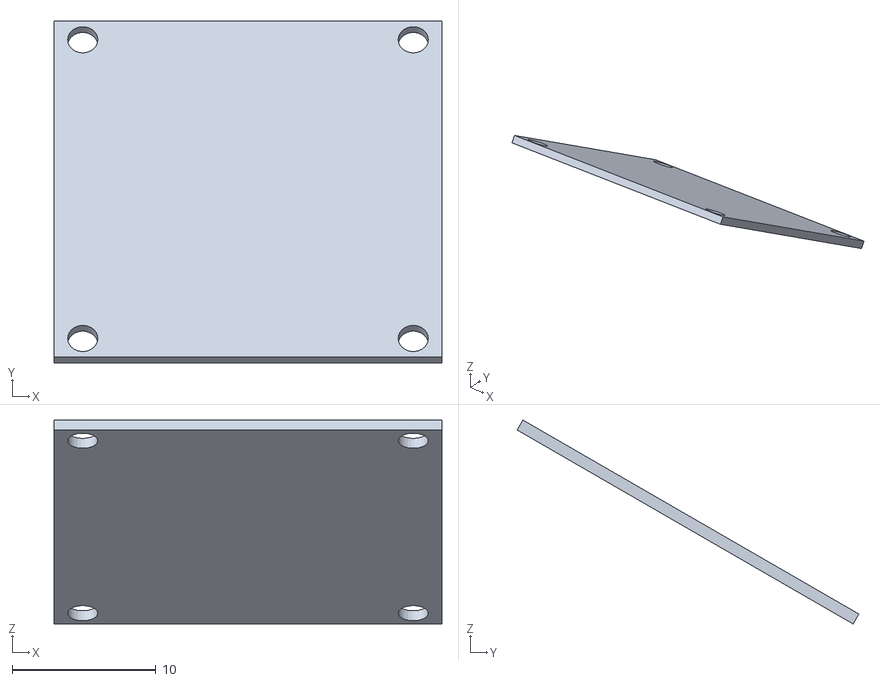
[picture p77: CAD file, 2026-10-30]
cad/out_v2_tilt30/stl/屏幕板.stl
27.0 x 23.8 x 14.2
