huiyi-li/esp32_show_tv/cad/out/stl/C10_触摸铜箔.stl

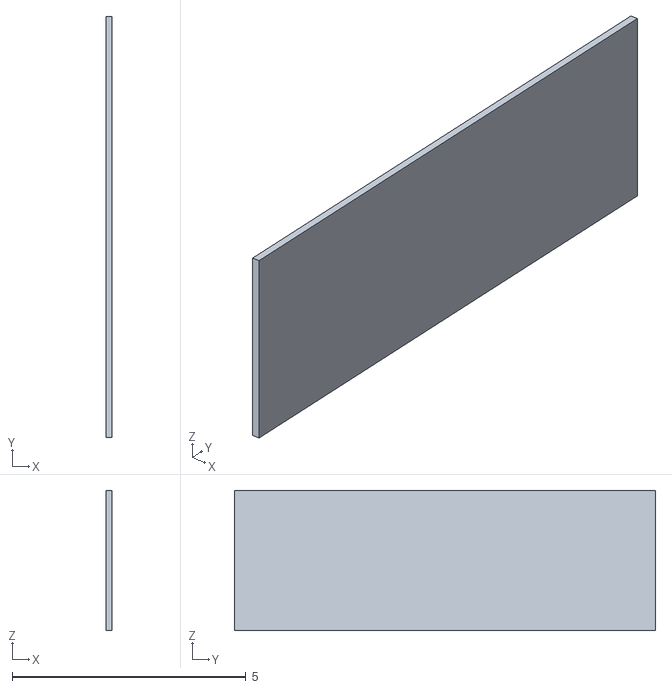
[picture p78: CAD file, 2026-10-30]
cad/out/stl/C10_触摸铜箔.stl
0.12 x 9.00 x 3.00
