huiyi-li/esp32_show_tv/cad/out_v2_tilt30/stl/主板.stl

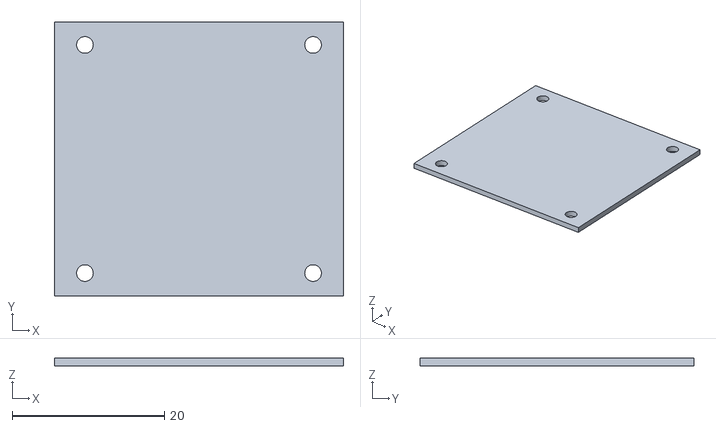
[picture p79: CAD file, 2026-10-30]
cad/out_v2_tilt30/stl/主板.stl
38.0 x 36.0 x 1.00
