huiyi-li/esp32_show_tv/cad/out_v2_tilt30/stl/电源模块.stl

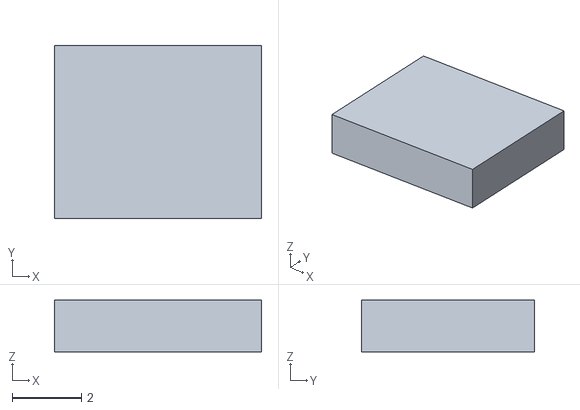
[picture p80: CAD file, 2026-10-30]
cad/out_v2_tilt30/stl/电源模块.stl
6.00 x 5.00 x 1.50
