huiyi-li/esp32_show_tv/cad/out/stl/外壳底座.stl

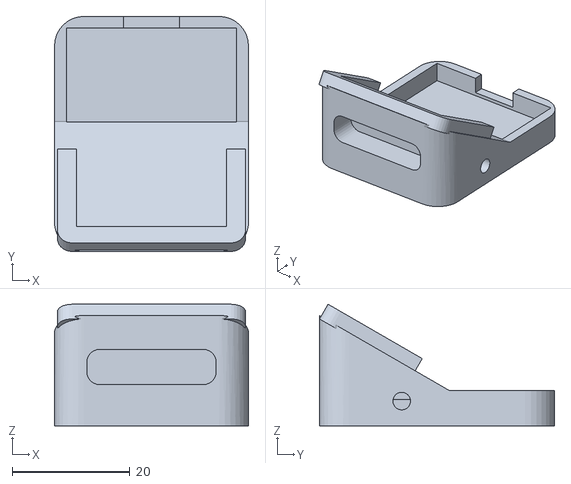
[picture p81: CAD file, 2026-10-30]
cad/out/stl/外壳底座.stl
33.0 x 40.0 x 20.7
