huiyi-li/esp32_show_tv/cad/out_v1_vertical/stl/FPC座.stl

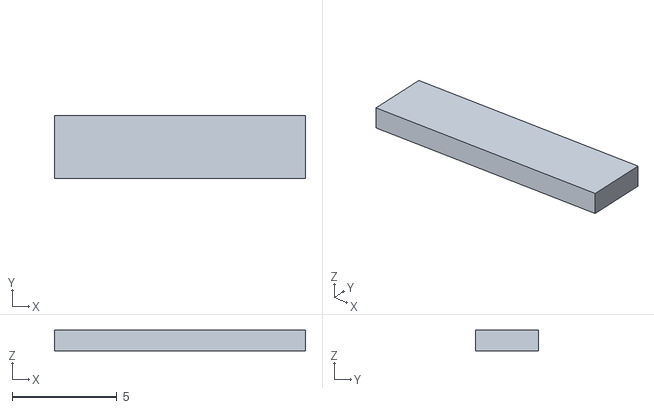
[picture p82: CAD file, 2026-10-30]
cad/out_v1_vertical/stl/FPC座.stl
12.0 x 3.00 x 1.00
