huiyi-li/esp32_show_tv/cad/out_v1_vertical/stl/棱镜卡座.stl

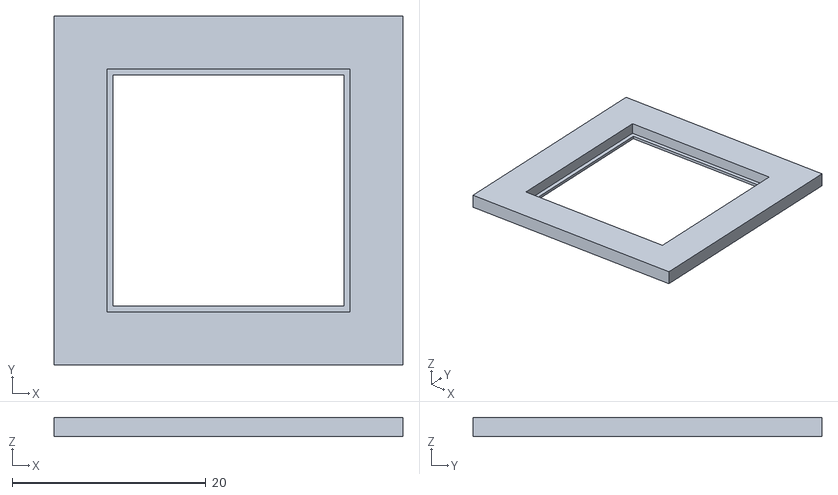
[picture p83: CAD file, 2026-10-30]
cad/out_v1_vertical/stl/棱镜卡座.stl
36.0 x 36.0 x 2.00
