huiyi-li/esp32_show_tv/cad/out_v2_tilt30/stl/遮光框.stl

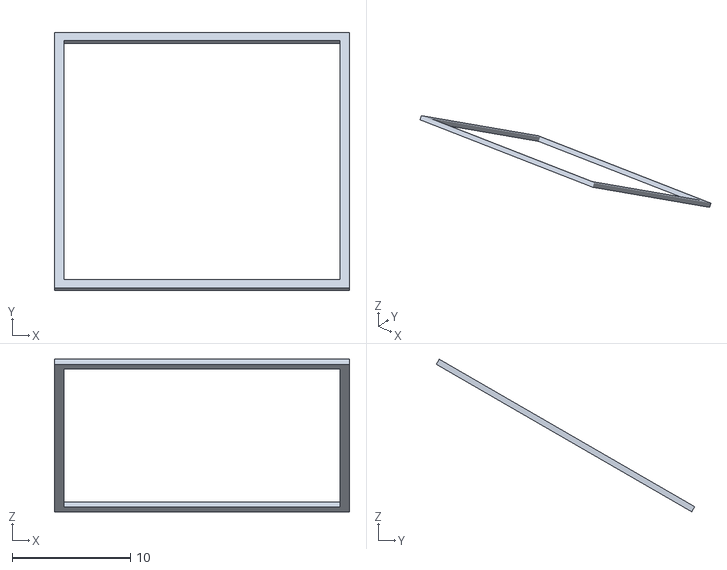
[picture p84: CAD file, 2026-10-30]
cad/out_v2_tilt30/stl/遮光框.stl
25.0 x 21.9 x 12.9
