huiyi-li/esp32_show_tv/cad/out_v1_vertical/stl/外壳底座.stl

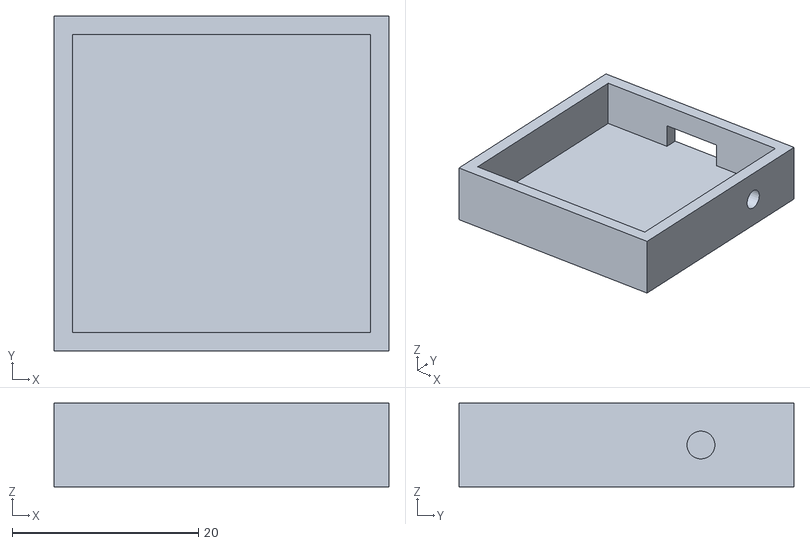
[picture p85: CAD file, 2026-10-30]
cad/out_v1_vertical/stl/外壳底座.stl
36.0 x 36.0 x 9.00
