huiyi-li/esp32_show_tv/cad/out_v2_tilt30/stl/分光棱镜.stl

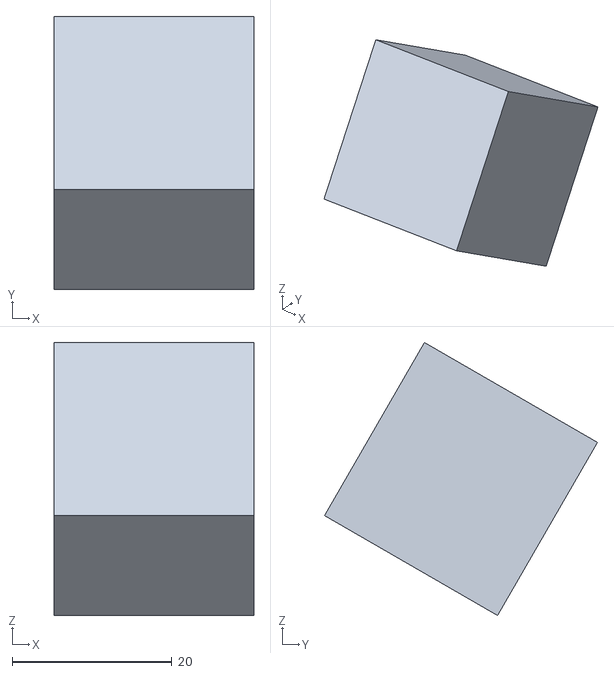
[picture p86: CAD file, 2026-10-30]
cad/out_v2_tilt30/stl/分光棱镜.stl
25.0 x 34.2 x 34.2
