huiyi-li/esp32_show_tv/cad/out_v2_tilt30/stl/PCB天线.stl

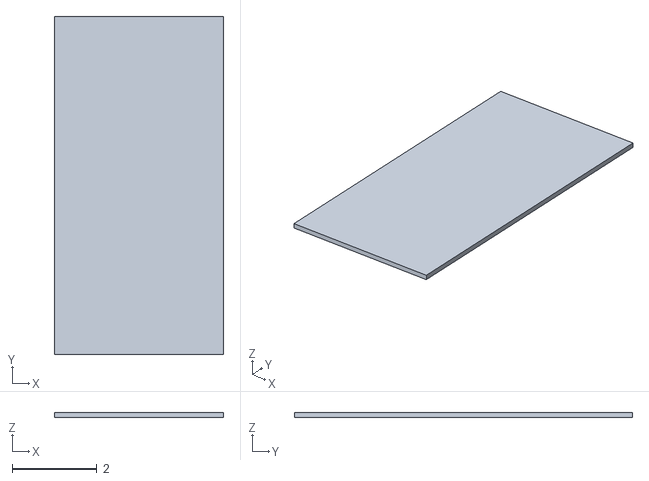
[picture p87: CAD file, 2026-10-30]
cad/out_v2_tilt30/stl/PCB天线.stl
4.00 x 8.00 x 0.12
