huiyi-li/esp32_show_tv/cad/out/stl/后支撑2.stl

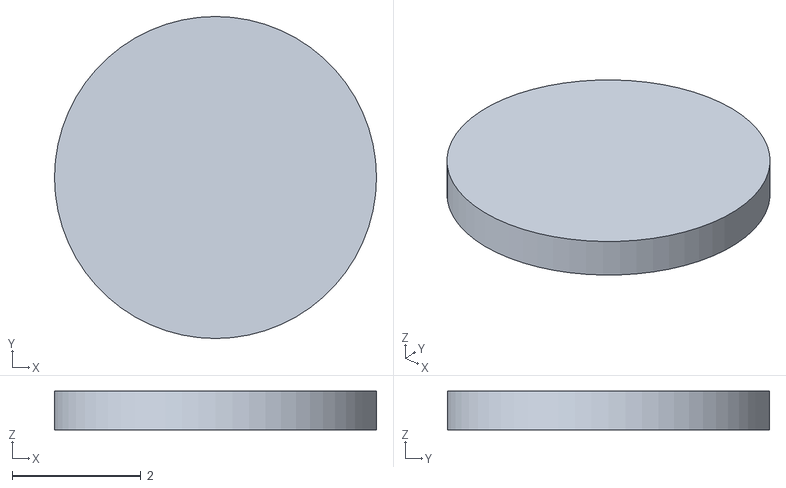
[picture p88: CAD file, 2026-10-30]
cad/out/stl/后支撑2.stl
5.00 x 5.00 x 0.6
