huiyi-li/esp32_show_tv/cad/out_v1_vertical/stl/连接器14P_公.stl

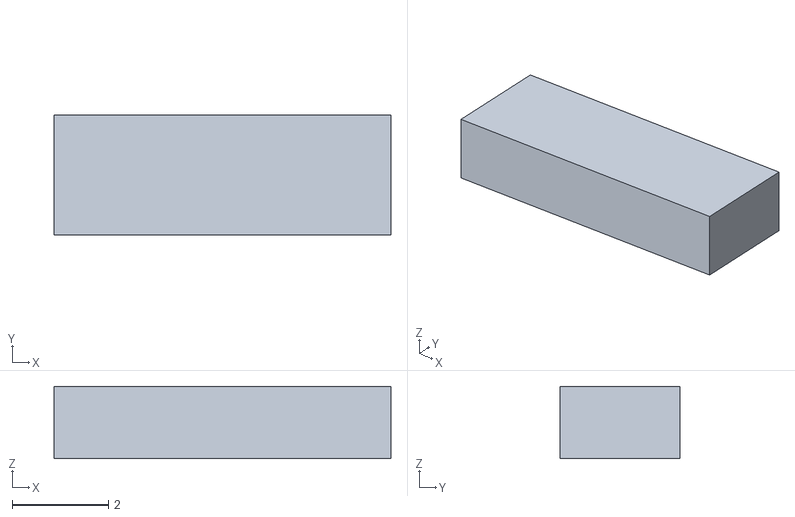
[picture p89: CAD file, 2026-10-30]
cad/out_v1_vertical/stl/连接器14P_公.stl
7.00 x 2.50 x 1.50
