huiyi-li/esp32_show_tv/cad/out/stl/P09_主板.stl

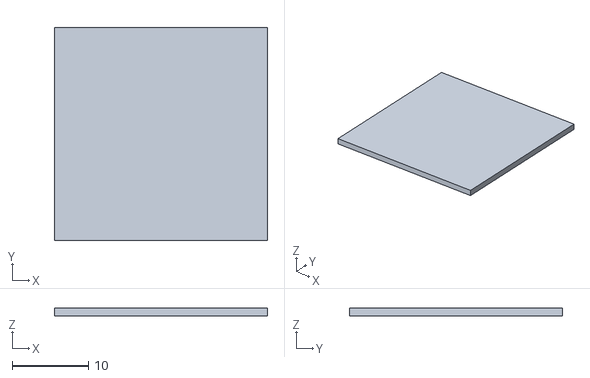
[picture p90: CAD file, 2026-10-30]
cad/out/stl/P09_主板.stl
28.0 x 28.0 x 1.00
