huiyi-li/esp32_show_tv/cad/out/stl/屏幕板.stl

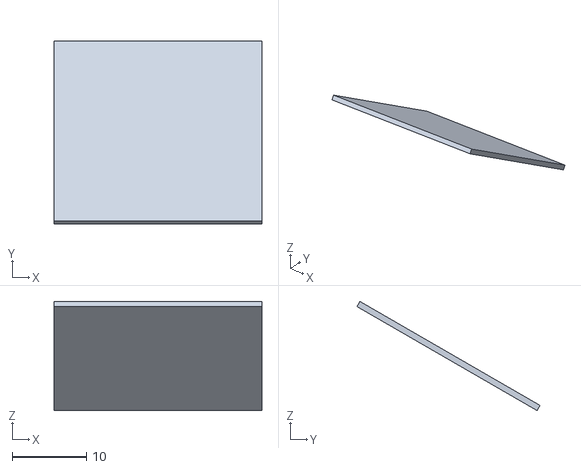
[picture p91: CAD file, 2026-10-30]
cad/out/stl/屏幕板.stl
28.0 x 24.6 x 14.7
