huiyi-li/esp32_show_tv/cad/out/stl/P03_屏幕板.stl

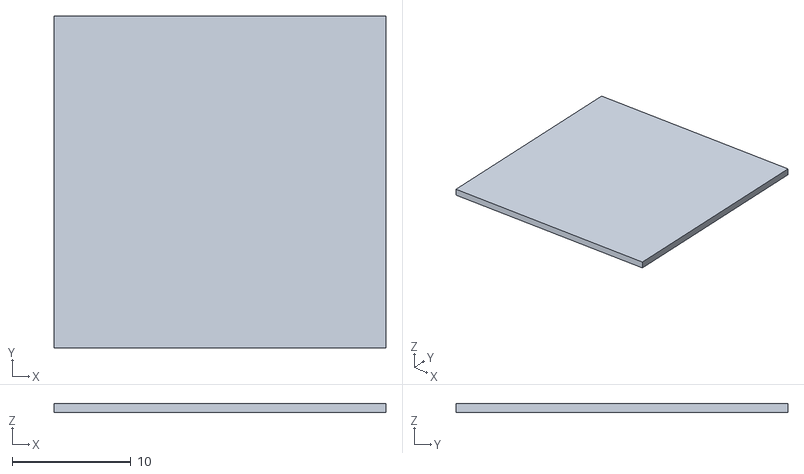
[picture p92: CAD file, 2026-10-30]
cad/out/stl/P03_屏幕板.stl
28.0 x 28.0 x 0.8
