huiyi-li/esp32_show_tv/cad/out/stl/分光膜.stl

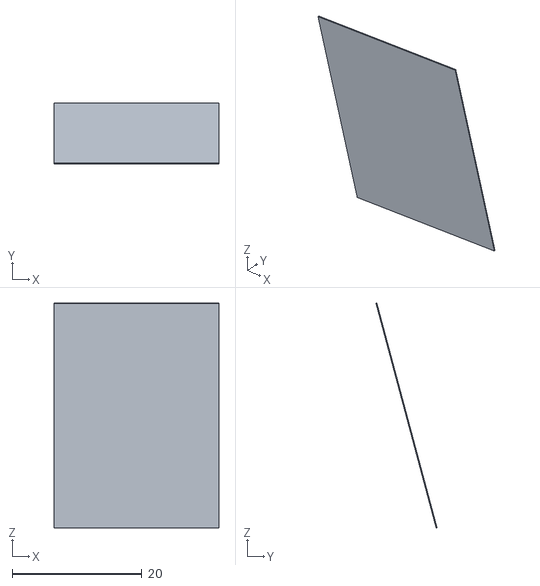
[picture p93: CAD file, 2026-10-30]
cad/out/stl/分光膜.stl
25.4 x 9.44 x 34.7
