huiyi-li/esp32_show_tv/cad/out/stl/P01_外壳底座.stl

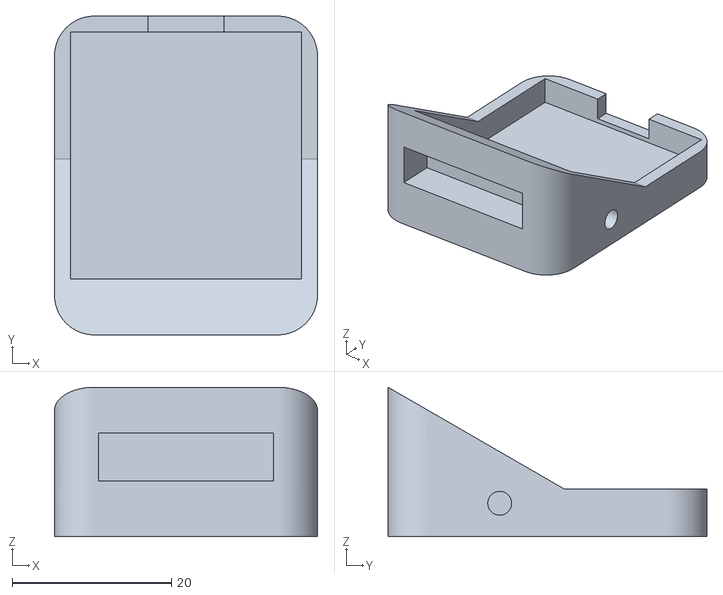
[picture p94: CAD file, 2026-10-30]
cad/out/stl/P01_外壳底座.stl
33.0 x 40.0 x 18.8
