huiyi-li/esp32_show_tv/cad/out/stl/遮光框.stl

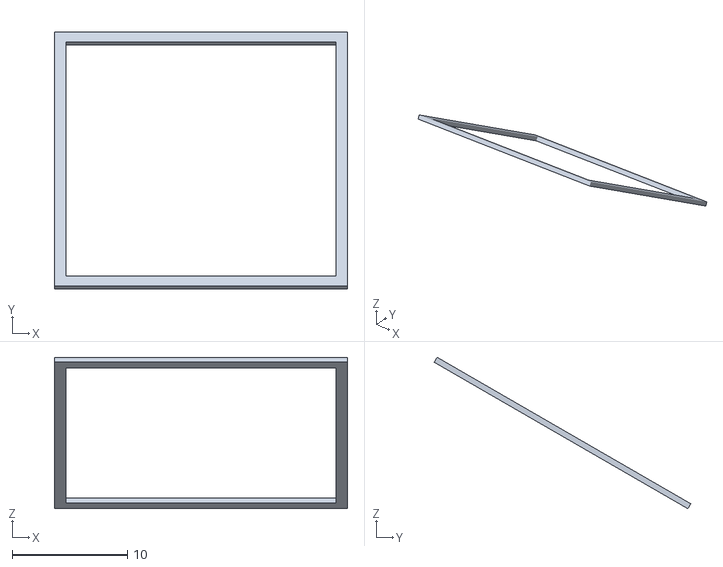
[picture p95: CAD file, 2026-10-30]
cad/out/stl/遮光框.stl
25.4 x 22.2 x 13.1
