huiyi-li/esp32_show_tv/cad/out/stl/分光棱镜.stl

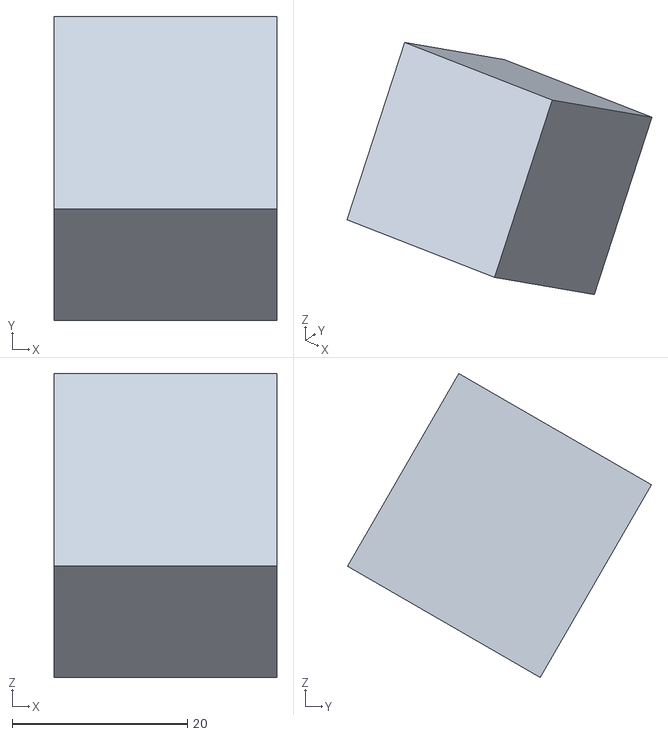
[picture p96: CAD file, 2026-10-30]
cad/out/stl/分光棱镜.stl
25.4 x 34.7 x 34.7
