huiyi-li/esp32_show_tv/(list of files, cad)

Other CAD files:
cad/out_v2_tilt30/stl/ESP32模块.stl
cad/out/stl/轻触键1.stl
cad/out/stl/C04_轻触键.stl
cad/out_v2_tilt30/stl/显示面板.stl
cad/out_v1_vertical/stl/棱镜护角2.stl
cad/out_v2_tilt30/stl/轻触键2.stl
cad/out_v1_vertical/stl/轻触键2.stl
cad/out_v2_tilt30/stl/轻触键1.stl
cad/out_v2_tilt30/stl/USB_C座.stl
cad/out/stl/C01_ESP32-PICO-D4.stl
cad/out/stl/轻触键2.stl
cad/out/stl/C12_后支撑柱.stl
cad/out_v2_tilt30/stl/MPU6050.stl
cad/out/stl/MPU6050.stl
cad/out_v1_vertical/stl/支撑柱3.stl
cad/out_v2_tilt30/stl/显示发光面.stl
cad/out_v1_vertical/stl/连接器14P.stl
cad/out_v2_tilt30/stl/棱镜护角2.stl
cad/out_v2_tilt30/stl/BH1750.stl
cad/out_v1_vertical/stl/触摸铜箔.stl
cad/out/stl/BH1750.stl
cad/out_v1_vertical/stl/USB_C座.stl
cad/out_v2_tilt30/stl/棱镜护角1.stl
cad/out/stl/触摸铜箔.stl
cad/out_v1_vertical/stl/棱镜护角4.stl
cad/out_v2_tilt30/stl/棱镜护角3.stl
cad/out/stl/C07_BH1750.stl
cad/out/stl/C08_Buck.stl
cad/out_v1_vertical/stl/棱镜护角3.stl
cad/out/stl/PCB天线.stl
cad/out_v1_vertical/stl/支撑柱2.stl
cad/out_v1_vertical/stl/支撑柱4.stl
cad/out/stl/主板.stl
cad/out/stl/C09_PCB_天线.stl
cad/out/stl/ESP32模块.stl
cad/out/stl/电源模块.stl
cad/out/stl/C06_MPU6050.stl
cad/out/stl/C05_轻触键.stl
cad/out/stl/后支撑1.stl
cad/out/stl/P04_显示面板.stl
cad/out/PrismTV_Assembly.FCStd
cad/out/PrismTV_v3_wedge.FCStd
cad/out_v1_vertical/PrismTV_Prototype_v1.FCStd
cad/out_v2_tilt30/PrismTV_v2_tilt30.FCStd
