huiyi-li/esp32_show_tv/cad/out/图纸/装配图.png

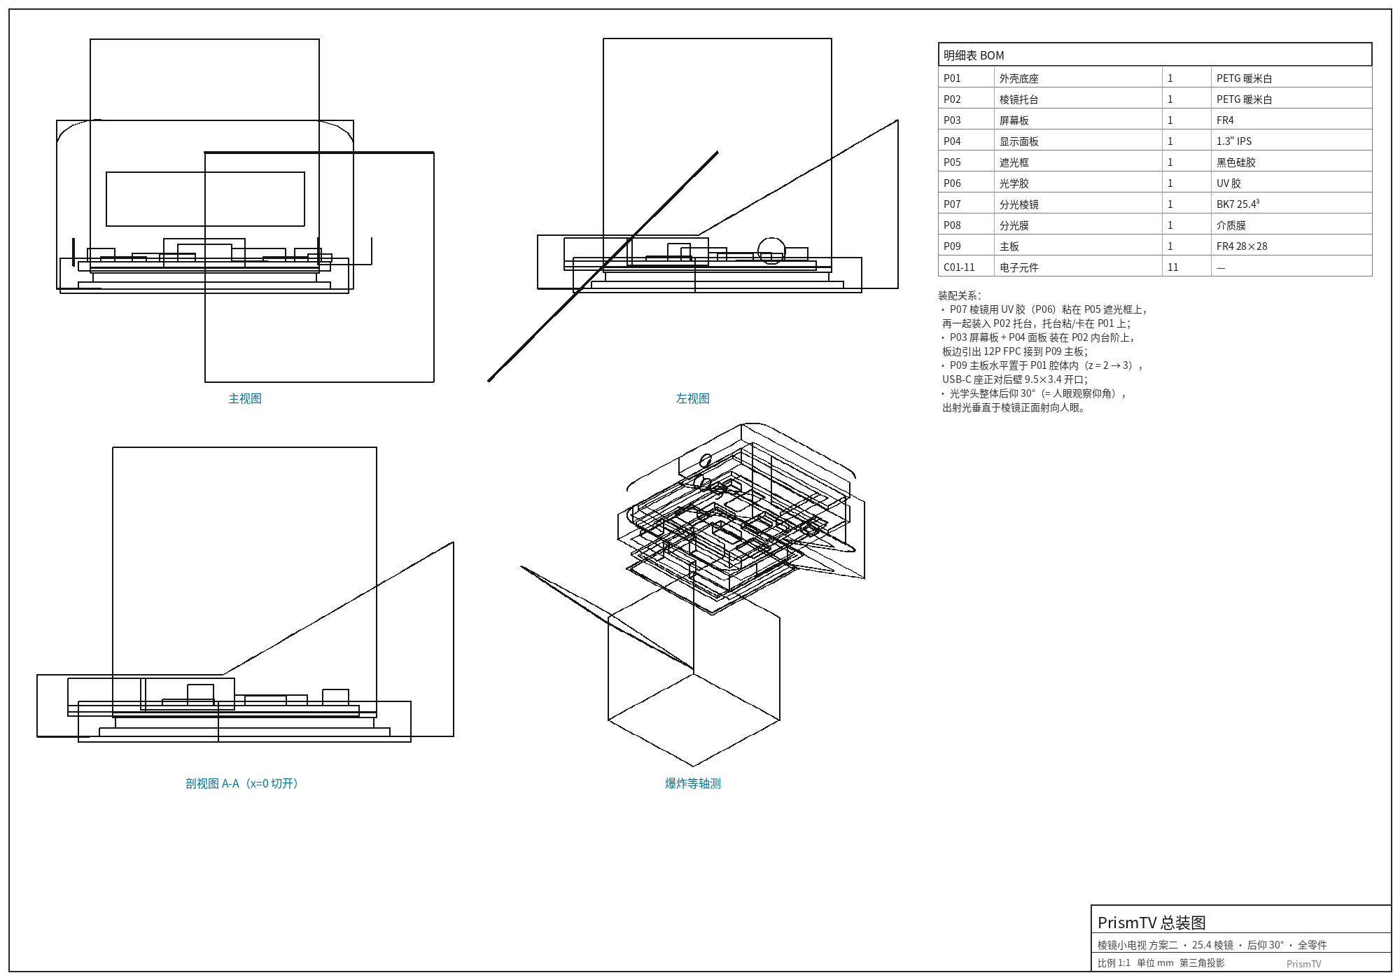
cad/out/图纸/装配图.png
