huiyi-li/esp32_show_tv/cad/out_v1_vertical/render/01_装配总览_等距.png

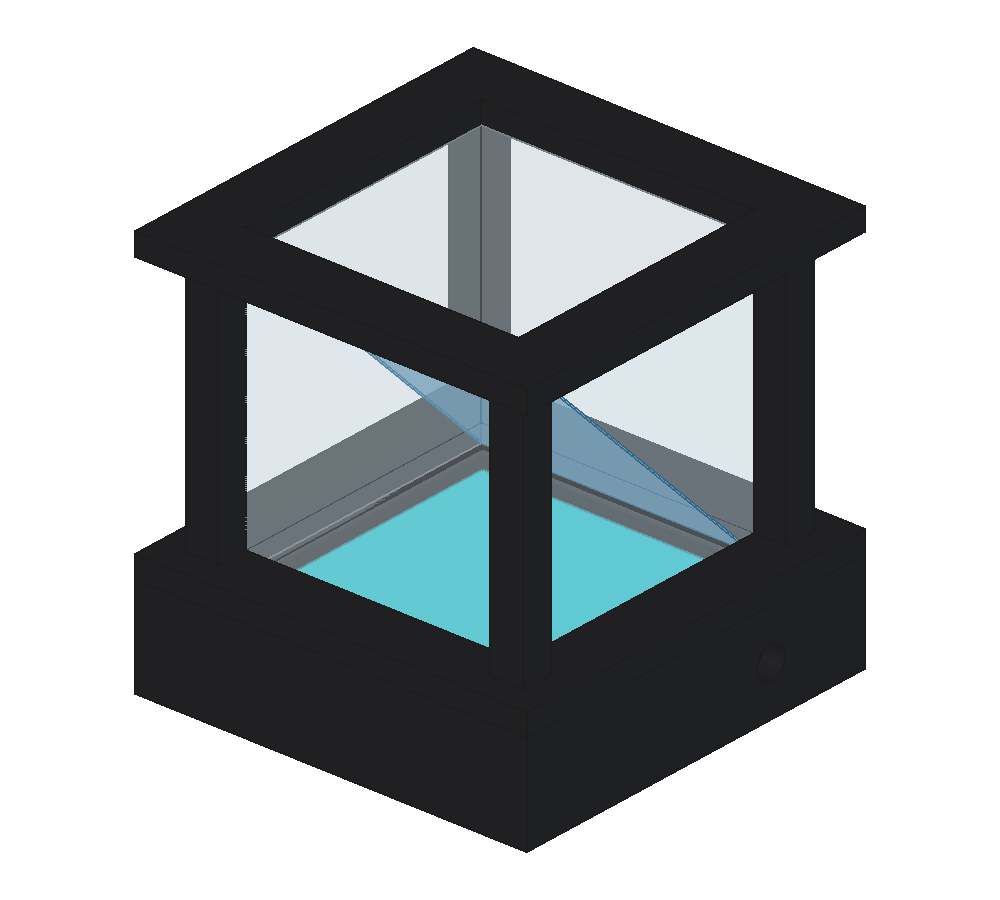
cad/out_v1_vertical/render/01_装配总览_等距.png
