huiyi-li/esp32_show_tv/(list of files, drawings)

Other design files:
firmware/.easyeda/artifacts/20261020-142608-pcb_dsn-63998a06.dsn
firmware/.easyeda/artifacts/20261020-144830-pcb_dsn-e31701ff.dsn
firmware/.easyeda/artifacts/20261020-145404-pcb_dsn-0c8b768c.dsn
firmware/.easyeda/artifacts/20261020-164913-pcb_dsn-cf98dcfb.dsn
firmware/.easyeda/artifacts/20261020-165314-pcb_dsn-e92e72b0.dsn
