huiyi-li/esp32_show_tv/firmware/main/assets_gen.h

/* 自动生成，请勿手改：由 tools/make_assets.py 产出 */
#pragma once

#define ANIM_FRAME_COUNT      20
#define ANIM_W                230
#define ANIM_H                115
#define ANIM_GLOW_BYTES       6670
#define ANIM_CORE_BYTES       3335
#define ANIM_BYTES_PER_FRAME  10005

#define WICON_COUNT           8
#define WICON_SIZE            48
#define WICON_PLANE_BYTES     1152
#define WICON_BYTES_PER_FRAME 2304
#define UI_ICON_COUNT         2
#define UI_ICON_SIZE          24
#define UI_ICON_BYTES         288
